OVGN/OpenIRV/README.md

# OpenIRV
Open-source thermal camera project
