OVGN/OpenIRV/SW/FPGA/README.md

# OIRV0901
OIRV0901 is a complete OpenIRV project, based on ISC0901 sensor.

# vivado-git-master
This is a great tool for easy Vivado version control, original repo: https://github.com/barbedo/vivado-git

Preparing Vivado project for use:
1. Download sources.
2. Lauch Vivado, open TCL console: Window -> TCL Console.
3. Run a TCL command: `source your_path_to_project_folder/OIRV0901.tcl`, Vivado will automatically restore project structure.
