OVGN/OpenIRV/docs/BOM/BOM_v1.1.0/OpenIRV_B-board_BOM_v1.1.0.xlsx

Comment | Quantity | Footprint | Designator | Description
B3SE-1002P | 4 | B3SE-1002P | SW0, SW1, SW2, SW3 | Tactile Switch
BM05B-SRSS-TB | 1 | BM05B-SRSS-TB | X1 | Connector
