OVGN/OpenIRV/docs/BOM/BOM_v1.1.0/OpenIRV_D-board_BOM_v1.1.0.xlsx

Comment | Value | Voltage | Dielectric | Tolerance | Quantity | Footprint | Designator | Description | ManufacturerPartNumber
1uF | 1uF | 25v | X7R | 10% | 4 | C0603[1608] | C1, C2, C3, C16 | Capacitor
10uF | 10uF | 50V | X7R | 10% | 4 | C1206[3216] | C4, C5, C6, C13 | Capacitor
0.1uF | 0.1uF | 50V | X7R | 10% | 3 | C0402[1005] | C7, C14, C15 | Capacitor
22uF | 22uF | 10V | X7R | 10% | 4 | C1206[3216] | C9, C10, C11, C12 | Capacitor
BZX384-C15.115 |  |  |  |  | 1 | BZX384 | D1 | Zener diode | BZX384-C15.115
MBRS260T3G |  |  |  |  | 1 | MBRS260T3G | D2 | Diode | MBRS260T3G
MBR0520LT1 |  |  |  |  | 1 | MBR0520LT1 | D3 | Diode | MBR0520LT1
CDRH6D28NP-100NC | 10uH |  |  |  | 1 | CDRH6D28NP-100NC | L1 | Inductor | CDRH6D28NP-100NC
ETQP3M2R2KVP | 2.2uH |  |  |  | 1 | ETQP3MXXXKVP | L2 | Inductor | ETQP3M2R2KVP
SQ2361ES-T1_GE3 |  |  |  |  | 1 | SQ2361ES-T1_GE3 | Q1 | MOSFET P-channel
10K | 10K |  |  | 5% | 2 | R0402[1005] | R1, R9 | Resistor
1K | 1K |  |  | 5% | 1 | R0402[1005] | R2 | Resistor
20R | 20R |  |  | 5% | 5 | R0402[1005] | R3, R4, R5, R6, R8 | Resistor
100R | 100R |  |  | 5% | 1 | R1206[3216] | R7 | Resistor
1M | 1M |  |  | 5% | 1 | R0402[1005] | R10 | Resistor
4.3K | 4.3K |  |  | 1% | 1 | R0603[1608] | R11 | Resistor
100K | 100K |  |  | 5% | 1 | R0402[1005] | R12 | Resistor
100K | 100K |  |  | 1% | 1 | R0603[1608] | R13 | Resistor
28K | 28K |  |  | 1% | 1 | R0603[1608] | R14 | Resistor
CAT4004AHU2-GT3 |  |  |  |  | 1 | CAT4004AHU2-GT3 | U1 | CAT4004AHU2-GT3
LMR33620CDDA |  |  |  |  | 1 | LMR33620CDDA | U2 | DC-DC Synchronous Step-Down converter 2A
XF2M-5015-1A |  |  |  |  | 1 | XF2M-5015-1A | X1 | ER-TFT023-1 TFT LCD Display 2.3" connector
BM14B-SRSS-TB |  |  |  |  | 1 | BM14B-SRSS-TB | X2 | Connector
