OVGN/OpenIRV/docs/BOM/BOM_v1.1.0/OpenIRV_F-board_BOM_v1.1.0.xlsx

Comment | Value | Tolerance | Power | Quantity | Designator | Footprint | Description
300R | 300R | 5% | 0.1W | 1 | R1 | R0603[1608] | Resistor
EE-SX1103 |  |  |  | 1 | U1 | EE-SX1103 | Photomicrosensor
SM03B-SRSS-TB |  |  |  | 1 | X1 | SM03B-SRSS-TB | Connector
SM02B-SRSS-TB |  |  |  | 4 | X2, X3, X4, X5 | SM02B-SRSS-TB | Connector
