OVGN/OpenIRV/docs/BOM/BOM_v1.1.0/OpenIRV_M-board_BOM_v1.1.0.xlsx

Comment | Description | Designator | Footprint | Quantity | Tolerance | Power | Value | Current | Dielectric | ManufacturerPartNumber | Voltage
4.7uF | Capacitor | C1, C2, C3, C9, C10, C15, C16, C21, C22, C26, C27, C33, C34, C38, C39, C93, C94, C100, C101 | C0402[1005] | 19 | 10% |  | 4.7uF |  | X5R |  | 6.3V
0.47uF | Capacitor | C4, C5, C6, C7, C8, C11, C12, C13, C14, C17, C18, C19, C23, C24, C25, C28, C29, C30, C31, C32, C35, C36, C37, C40, C41, C42, C64 | C0402[1005] | 27 | 10% |  | 0.47uF |  | X5R |  | 6.3V
0.1uF | Capacitor | C20, C54, C92, C95, C96, C97, C102, C103, C104, C107, C108, C109, C110 | C0402[1005] | 13 | 10% |  | 0.1uF |  | X7R |  | 50V
10uF | Capacitor | C43, C57, C58, C59, C61, C67, C68, C73, C74, C75, C76, C82, C83, C90, C91 | C0805[2012] | 15 | 10% |  | 10uF |  | X7R |  | 10V
10uF | Capacitor | C45, C46, C49, C50, C52, C53 | C1206[3216] | 6 | 10% |  | 10uF |  | X7R |  | 16V
1uF | Feed Through Capacitor | C47, C48 | NFM21PC | 2 | 20% |  | 1uF | 4A |  | NFM21PC105B1C3D | 16V
0.01uF | Capacitor | C51, C60, C98, C99, C105, C106 | C0402[1005] | 6 | 10% |  | 0.01uF |  | X7R |  | 50V
1uF | Feed Through Capacitor | C55, C56, C80, C81 | NFM18PS | 4 | 20% |  | 1uF | 2A |  | NFM18PS105R0J3D | 6.3V
22uF | Capacitor | C62, C63, C65, C66, C70, C71, C72, C78, C79, C84, C85, C87, C88, C89 | C1206[3216] | 14 | 10% |  | 22uF |  | X7R |  | 10V
120pF | Capacitor | C69 | C0402[1005] | 1 | 10% |  | 120pF |  | X7R |  | 50v
33pF | Capacitor | C77 | C0402[1005] | 1 | 5% |  | 33pF |  | NP0 |  | 50V
SP1001-04JTG | ESD protection diode | D1, D2, D3 | SP1001-04JTG | 3
MBR0520LT1 | Diode | D4 | MBR0520LT1 | 1 |  |  |  |  |  | MBR0520LT1
BLM18KG471SN1D | Ferrite bead | FB1, FB3 | L0603[1608] | 2 |  |  |  | 1.5A |  | BLM18KG471SN1D
BLM15AX102SN1D | Ferrite bead | FB2 | L0402[1005] | 1 |  |  |  | 0.35A |  | BLM15AX102SN1D
BLM15AX601SN1D | Ferrite bead | FB4 | L0402[1005] | 1 |  |  |  | 0.5A |  | BLM15AX601SN1D
BLM15PD121SN1D | Ferrite bead | FB5 | L0402[1005] | 1 |  |  |  | 1.3A |  | BLM15PD121SN1D
SG-8018CG XX.XXXXM-TJHSA3 | Oscillator | G1 | SG-8018CG XX.XXXXM-TJHSA3 | 1 |  |  |  |  |  | SG-8018CG XX.XXXXM-TJHSA3
LQM21PN4R7MGRD | Inductor | L1 | L0805[2012] | 1 |  |  | 4.7uH |  |  | LQM21PN4R7MGRD
LQM2HPN2R2MG0L | Inductor | L2, L4 | LQM2HPNXXXXG0X | 2 |  |  | 2.2uH |  |  | LQM2HPN2R2MG0L
DFE252012P-R47M=P2 | Inductor | L3 | DFE252012P-XXXM=P2 | 1 |  |  | 0.47uH |  |  | DFE252012P-R47M=P2
LQM2HPN1R5MG0L | Inductor | L5 | LQM2HPNXXXXG0X | 1 |  |  | 1.5uH |  |  | LQM2HPN1R5MG0L
FDV303N | MOSFET N-channel | Q1, Q2 | FDV303N | 2
FDN306P | MOSFET P-channel | Q3 | FDN306P | 1
22R | Resistor array | R1, R2, R3, R4, R5, R7, R8 | R0804 | 7 | 5% | 0.06W | 22R
10K | Resistor | R6, R10, R11, R12, R13, R14, R20, R24, R28, R32, R36, R40, R45, R49, R55, R58, R65, R66, R67, R68, R69 | R0402[1005] | 21 | 5% | 0.06W | 10K
4.7K | Resistor | R9, R22, R23, R25, R26 | R0402[1005] | 5 | 5% | 0.06W | 4.7K
20R | Resistor | R15, R16, R17, R18, R19, R21 | R0402[1005] | 6 | 5% | 0.06W | 20R
100K | Resistor | R27, R47, R51 | R0603[1608] | 3 | 1% | 0.1W | 100K
15.4K | Resistor | R29 | R0603[1608] | 1 | 1% | 0.1W | 15.4K
60.4K | Resistor | R30 | R0603[1608] | 1 | 1% | 0.1W | 60.4K
47R | Resistor | R31, R39, R56 | R0402[1005] | 3 | 5% | 0.06W | 47R
1R | Resistor | R33, R41 | R0603[1608] | 2 | 1% | 0.1W | 1R
10R | Resistor | R34 | R0603[1608] | 1 | 1% | 0.1W | 10R
17.8K | Resistor | R35 | R0603[1608] | 1 | 1% | 0.1W | 17.8K
2.7K | Resistor | R37 | R0603[1608] | 1 | 1% | 0.1W | 2.7K
10.5K | Resistor | R38 | R0603[1608] | 1 | 1% | 0.1W | 10.5K
0R1 | Resistor | R42, R57 | R0603[1608] | 2 | 1% | 0.1W | 0R1
12K | Resistor | R43 | R0603[1608] | 1 | 1% | 0.1W | 12K
3.83K | Resistor | R46 | R0603[1608] | 1 | 1% | 0.1W | 3.83K
49.9K | Resistor | R48 | R0603[1608] | 1 | 1% | 0.1W | 49.9K
68K | Resistor | R50, R59 | R0603[1608] | 2 | 1% | 0.1W | 68K
56K | Resistor | R52 | R0603[1608] | 1 | 1% | 0.1W | 56K
130K | Resistor | R53 | R0603[1608] | 1 | 1% | 0.1W | 130K
12.4K | Resistor | R54 | R0603[1608] | 1 | 1% | 0.1W | 12.4K
11.3K | Resistor | R60 | R0603[1608] | 1 | 1% | 0.1W | 11.3K
1K | Resistor | R61, R62 | R0402[1005] | 2 | 5% | 0.06W | 1K
100K | Resistor | R63, R64 | R0402[1005] | 2 | 5% | 0.06W | 100K
XC7S50-1CSGA324C | Spartan-7 FPGA, pin compatible with 7S25 | U1 | XC7S50-1CSGA324C | 1
MX25L12835F | Quad SPI NOR Flash 128Mbit | U2 | MX25L12835F | 1
TPS61041DBVR | DC-DC boost converter | U3 | TPS61041DBVR | 1
TPS7A4901DGNR | Ultralow-Noise Positive LDO 150ma | U4 | TPS7A4901DGNR | 1
TPS7A9001DSKR | LDO Low-Noise 500ma | U5 | TPS7A9001DSKR | 1
TPS62400DRCT | Dual Step-Down DC-DC | U6 | TPS62400DRCT | 1
TPS62821DLCR | DC-DC Step-Down Converter | U7 | TPS62821DLCR | 1
TPS63030DSKR | DC-DC 1A Buck-Boost Converter | U8 | TPS63030DSKR | 1
LP5912-3.3DRVR | LDO 500ma, Fixed 3.3 V | U9 | LP5912-3.3DRVR | 1
W956D8MBYA5I | HyperBus PSRAM 64Mbit | U10, U11 | W956D8MBYA5I | 2
NC7WZ07P6X | Dual open-drain buffer | U12 | NC7WZ07P6X | 1
SN74LVC1T45DBVR | Single-Bit Dual-Supply Bus Transceiver | U13, U14, U15 | SN74LVC1T45DBVR | 3
DF17-80 | Connector | X1 | DF17(2.0)-80DP-0.5V(57) | 1
52991-0408 (ISC0901B0 pinout) | Molex 40 pin receptacle | X2 | 52991-0408 | 1
SM10B-SRSS-TB | Connector | X3 | SM10B-SRSS-TB | 1
84953-6 | Connector | X4 | 84953-6 | 1
