OVGN/OpenIRV/docs/BOM/BOM_v1.1.0/OpenIRV_P-board_BOM_v1.1.0.xlsx

Comment | Description | Designator | Footprint | Quantity | ManufacturerPartNumber | Power | Tolerance | Value | Current | Dielectric | Voltage
1095 | Battery holder 18350 | BT1 | 1095 | 1
12pF | Capacitor | C1, C2 | C0402[1005] | 2 |  |  | 5% | 12pF |  | NP0 | 50V
0.1uF | Capacitor | C3, C4, C7, C8, C9, C10, C11, C13, C15, C19, C20, C21, C22, C23, C24, C34, C35, C36, C37, C47 | C0402[1005] | 20 |  |  | 10% | 0.1uF |  | X7R | 50V
1uF | Capacitor | C5, C17, C18, C45, C48 | C0603[1608] | 5 |  |  | 10% | 1uF |  | X7R | 25V
10uF | Capacitor | C6, C12, C14, C39, C40, C43, C44 | C0805[2012] | 7 |  |  | 10% | 10uF |  | X7R | 10V
22uF | Capacitor | C16, C38 | C1206[3216] | 2 |  |  | 10% | 22uF |  | X7R | 10V
2.2nF | Capacitor | C25 | C0603[1608] | 1 |  |  | 10% | 2.2nF |  | X7R | 50V
1uF | Feed Through Capacitor | C26, C31 | NFM18PS | 2 | NFM18PS105R0J3D |  | 20% | 1uF | 2A |  | 6.3V
12nF | Capacitor | C27 | C0603[1608] | 1 |  |  | 10% | 12nF |  | X7R | 50V
4.7uF | Capacitor | C28, C29, C32, C33 | C0402[1005] | 4 |  |  | 10% | 4.7uF |  | X5R | 6.3V
150nF | Capacitor | C30 | C0603[1608] | 1 |  |  | 10% | 150nF |  | X7R | 50V
0.22uF | Capacitor | C41, C46 | C0603[1608] | 2 |  |  | 10% | 0.22uF |  | X7R | 25V
0.01uF | Capacitor | C42 | C0402[1005] | 1 |  |  | 10% | 0.01uF |  | X7R | 50V
USBLC6-2P6 | ESD protection diode | D1 | USBLC6-2P6 | 1
BAS70JFILM | Diode | D2, D4, D12 | BAS70JFILM | 3 | BAS70JFILM
SP3012-04UTG | ESD protection diode | D3, D6 | SP3012-04UTG | 2
SP1001-04JTG | ESD protection diode | D5, D11 | SP1001-04JTG | 2
SP1001-02JTG | ESD protection diode | D7 | SP1001-02JTG | 1
WP117EYWT | LED | D8 | LED_AXIAL[7x5x2] | 1 | WP117EYWT
BZX384-C15.115 | Zener diode | D9 | BZX384 | 1 | BZX384-C15.115
SMBJ33A/CA | TVS diode | D10 | SMBJ33A/CA | 1 | SMBJ33A/CA
BAR43CFILM | Diode | D13, D14 | BAR43CFILM | 2
L-117EGWT | LED | D15 | LED_AXIAL[7x5x2] | 1 | L-117EGWT
BLM15AX102SN1D | Ferrite Bead | FB1, FB2, FB3 | L0402[1005] | 3 | BLM15AX102SN1D |  |  |  | 0.35A
LQM21PN4R7MGRD | Inductor | L1, L2, L3, L4, L5 | L0805[2012] | 5 | LQM21PN4R7MGRD |  |  | 4.7uH
97730506332R | Spacer M1.6 | MH1, MH2 | 97730506332R | 2
NTJD4401NT1G | Dual N-channel mosfet | Q1, Q2, Q4, Q5 | NTJD4401NT1G | 4
SQ2361ES-T1_GE3 | MOSFET P-channel | Q3 | SQ2361ES-T1_GE3 | 1
SI2333DDS-T1-GE3 | MOSFET P-channel | Q6, Q7 | SI2333DDS-T1-GE3 | 2
2.4K | Resistor | R1, R2, R16, R17 | R0402[1005] | 4 |  | 0.06W | 5% | 2.4K
10K | Resistor | R3, R4, R5, R6, R7, R8, R9, R10, R19, R22, R23, R24, R25, R26, R27, R28, R31, R33, R34, R37, R38, R39, R40, R47, R48, R52, R53, R58, R59, R61, R62, R63, R66, R67, R70, R71, R72, R79 | R0402[1005] | 38 |  | 0.06W | 5% | 10K
49R9 | Resistor | R11, R12, R13, R14 | R0404 | 4 |  | 0.06W | 1% | 49R9
27K | Resistor | R15, R21 | R0603[1608] | 2 |  | 0.1W | 1% | 27K
0R | Resistor | R18, R36, R41 | R0402[1005] | 3 |  | 0.06W | 5% | 0R
1K | Resistor | R20, R32, R42, R43, R44, R45, R46, R57, R69, R74, R75, R76 | R0402[1005] | 12 |  | 0.06W | 5% | 1K
62R | Resistor | R29, R35 | R0603[1608] | 2 |  | 0.1W | 5% | 62R
0466002.NR | Fuze | R30 | R1206[3216] | 1 | 0466002.NR |  |  |  | 2A
300R | Resistor | R49 | R0603[1608] | 1 |  | 0.1W | 1% | 300R
169R | Resistor | R50 | R0603[1608] | 1 |  | 0.1W | 1% | 169R
4.12K | Resistor | R51 | R0603[1608] | 1 |  | 0.1W | 1% | 4.12K
75R | Resistor | R54 | R0603[1608] | 1 |  | 0.1W | 1% | 75R
240R | Resistor | R55 | R0603[1608] | 1 |  | 0.1W | 5% | 240R
200R | Resistor | R56 | R0603[1608] | 1 |  | 0.1W | 5% | 200R
0ZCM0010FF2G | Fuze | R60 | R0603[1608] | 1 | 0ZCM0010FF2G |  |  |  | 0.1A
1.07K | Resistor | R64 | R0603[1608] | 1 |  | 0.1W | 1% | 1.07K
33.2K | Resistor | R65 | R0603[1608] | 1 |  | 0.1W | 1% | 33.2K
60.4K | Resistor | R68 | R0603[1608] | 1 |  | 0.1W | 1% | 60.4K
680R | Resistor | R73 | R0603[1608] | 1 |  | 0.1W | 1% | 680R
0.05R | Resistor | R77, R78 | R1206[3216] | 2 |  | 0.25W | 1% | 0.05R
EVQP7L01P | Tactile Switch | SW1 | EVQP7L01P | 1 | EVQP7L01P
CY7C68013A-56PVXI | EZ-USB(R) FX2LP(TM) USB Microcontroller High-Speed USB Peripheral Controller, 16 KB, 24 I/Os, 3 to 3.6 V, -40 to 85 degC, 56-Pin SSOP (PVX56), Tube | U1 | CY7C68013A-56PVXI | 1
NCV361SNT1G | USB Positive Overvoltage/Overcurrent Protection | U2 | NCV361SNT1G | 1
NL17SZ125DFT2G | Non-Inverting 3-State Buffer | U3 | NL17SZ125DFT2G | 1
M41T62LC6F | Real Time Clock | U4 | M41T62LC6F | 1
DRV8835DSSR | Dual Low Voltage H-Bridge IC | U5 | DRV8835DSSR | 1
PCA9539PW | PCA9539PW | U6 | PCA9539PW | 1
ADV7391BCPZ | 10-bit SD/HD Video Encoder | U7 | ADV7391BCPZ | 1
ADA4432-1BRJZ-R2 | Analog Video output buffer | U8 | ADA4432-1BRJZ-R2 | 1
BQ24032ARHLR | Dual Input Li-Ion Charger with Dynamic Power Path, Output regulated to 4.4 V, Vbat 4.2 V, 4.3 V, -40 to 85 degC, 20-pin QFN (RHL), Green (RoHS & no Sb/Br) | U9 | BQ24032ARHLR | 1
TPS61222DCKR | DC-DC Boost converter | U10 | TPS61222DCKR | 1
STC3115AIQT | Gas gauge IC with alarm output for handheld applications | U11 | STC3115AIQT | 1
LC05111C02MTTTG | 1-Cell Lithium-Ion Battery Protection IC with Integrated Power MOSFET | U12 | LC05111C02MTTTG | 1
61400416121 | USB 2.0 type B | X1 | 61400416121 | 1
DF17-80 | Connector | X2 | DF17(3.0)-80DS-0.5V(57) | 1
DM3AT-SF-PEJM5 | SD card slot | X3 | DM3AT-SF-PEJM5 | 1
HDMI receptacle connector | Connector | X4 | 471510001_EDGE_HOLE | 1
BM14B-SRSS-TB | Connector | X5 | BM14B-SRSS-TB | 1
BM02B-SRSS-TB | Connector | X6 | BM02B-SRSS-TB | 1
SM02B-SRSS-TB | Connector | X7 | SM02B-SRSS-TB | 1
S7B-XH-A | JST connector 2.5mm 7-pin | X8 | S7B-XH-A | 1
BM03B-SRSS-TB | Connector | X9 | BM03B-SRSS-TB | 1
BM05B-SRSS-TB | Connector | X10 | BM05B-SRSS-TB | 1
KX-7T | Crystal | Y1 | Crystal[3225] | 1 | KX-7T
