OVGN/OpenIRV/HW/mechanical/STEP/focus/motor_mount.stp

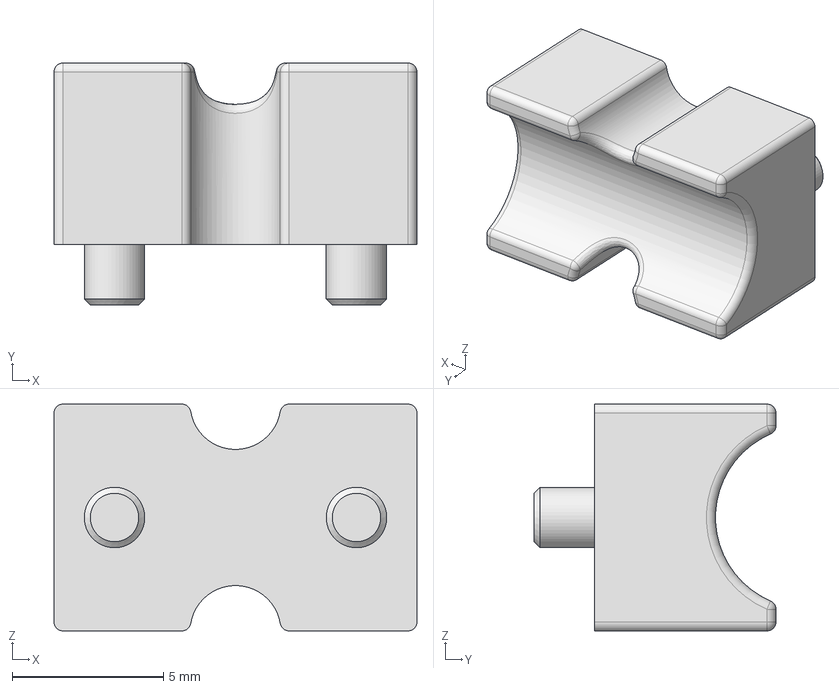
[picture p5: CAD file, 2020-08-25]
HW/mechanical/STEP/focus/motor_mount.stp
12.0 x 8.00 x 7.50 mm
