OVGN/OpenIRV/HW/mechanical/STEP/housing/buttons/buttons_matrix.stp

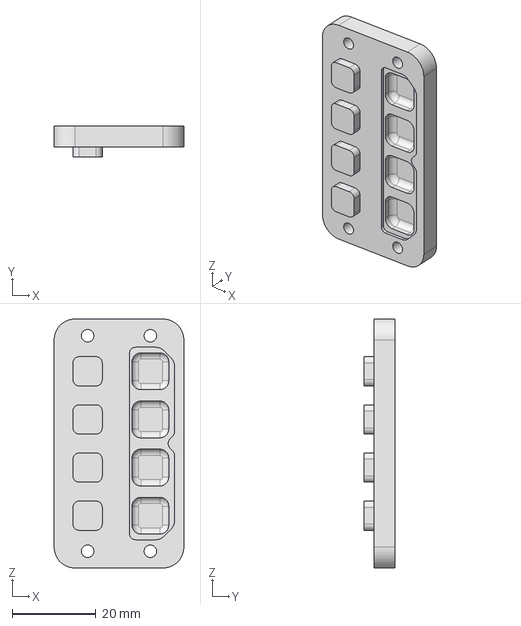
[picture p6: CAD file, 2020-08-25]
HW/mechanical/STEP/housing/buttons/buttons_matrix.stp
31.0 x 7.30 x 59.5 mm
