OVGN/OpenIRV/HW/mechanical/STEP/housing/top.stp

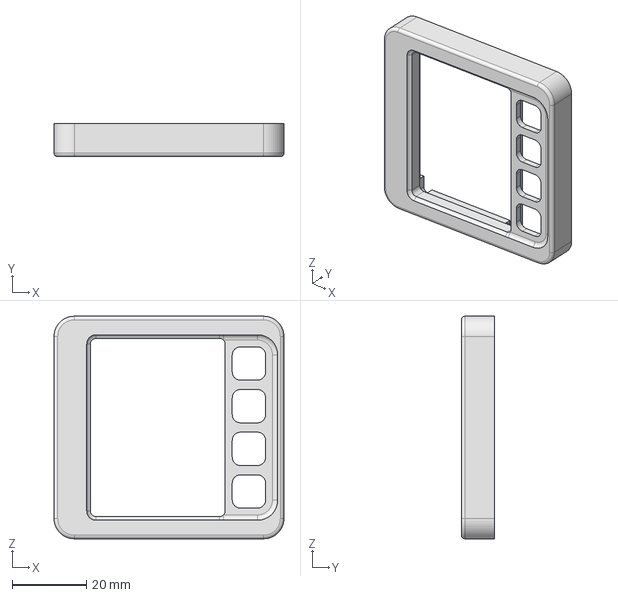
[picture p7: CAD file, 2020-08-25]
HW/mechanical/STEP/housing/top.stp
62.0 x 9.00 x 60.0 mm
