OVGN/OpenIRV/HW/mechanical/STEP/pixelshift/pixelshift_xy_stage.stp

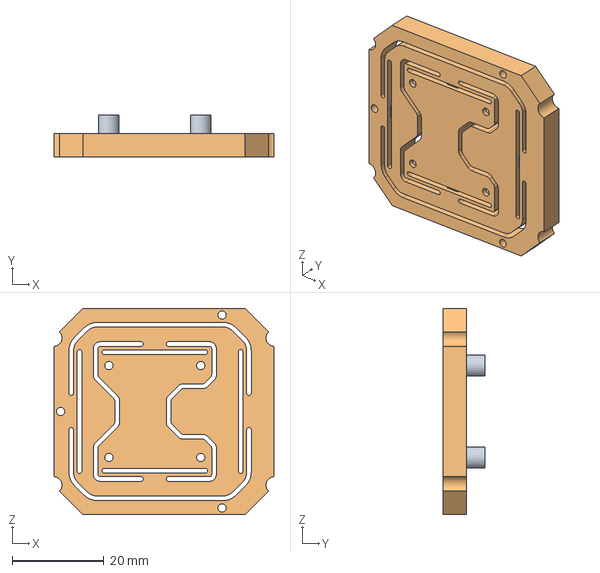
[picture p8: CAD file, 2020-11-22]
HW/mechanical/STEP/pixelshift/pixelshift_xy_stage.stp
47.9 x 9.10 x 44.9 mm
