OVGN/OpenIRV/HW/mechanical/STEP/focus/focus_worm.stp

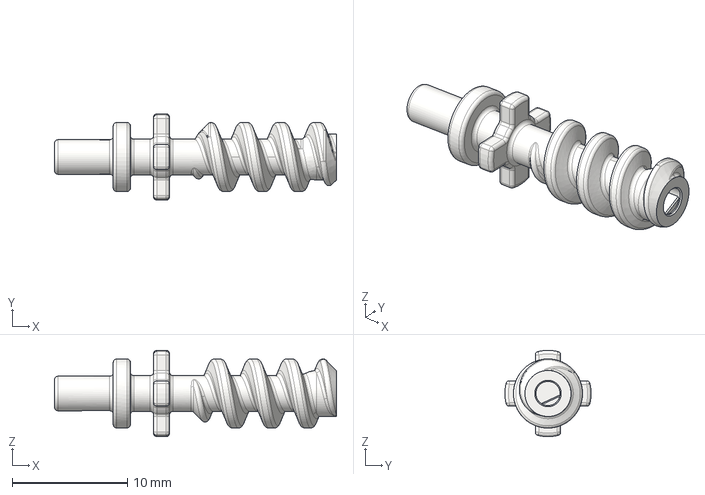
[picture p9: CAD file, 2020-08-25]
HW/mechanical/STEP/focus/focus_worm.stp
24.5 x 7.50 x 7.50 mm
