OVGN/OpenIRV/HW/mechanical/STEP/housing/buttons/buttons.stp

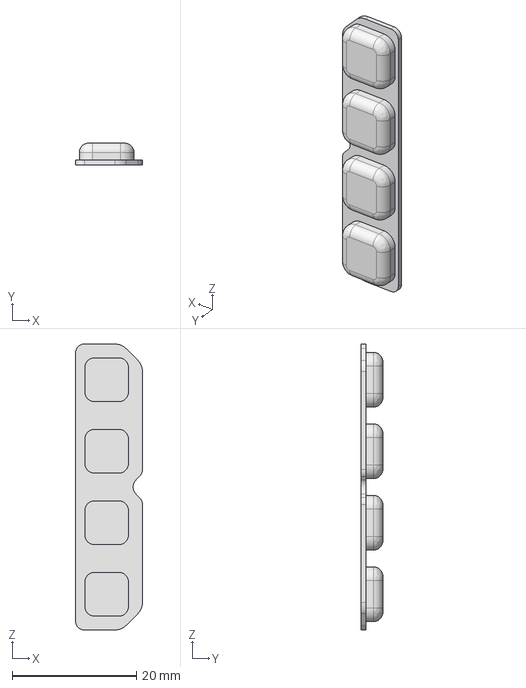
[picture p10: CAD file, 2020-08-25]
HW/mechanical/STEP/housing/buttons/buttons.stp
10.8 x 3.50 x 46.0 mm
