OVGN/OpenIRV/HW/mechanical/STEP/housing/middle.stp

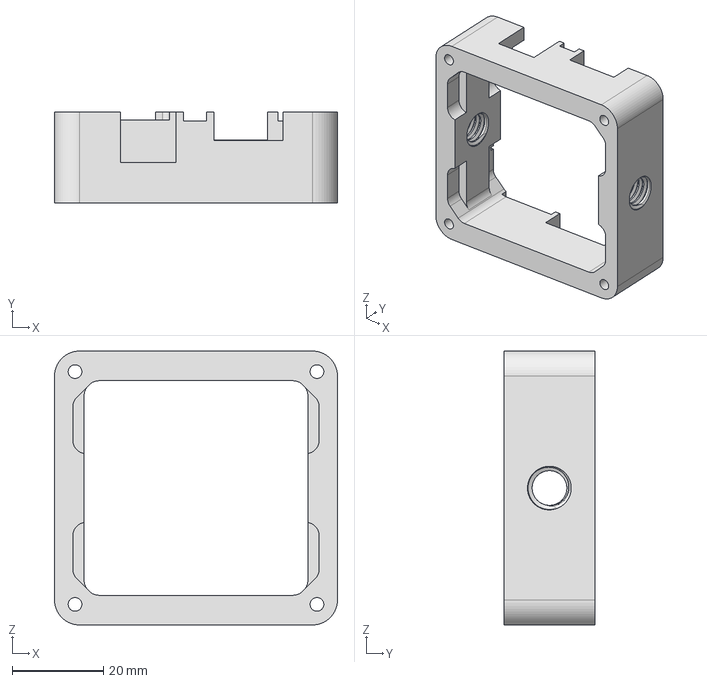
[picture p11: CAD file, 2020-08-25]
HW/mechanical/STEP/housing/middle.stp
62.0 x 20.0 x 60.0 mm
