OVGN/OpenIRV/HW/mechanical/STEP/focus/focus_wheel.stp

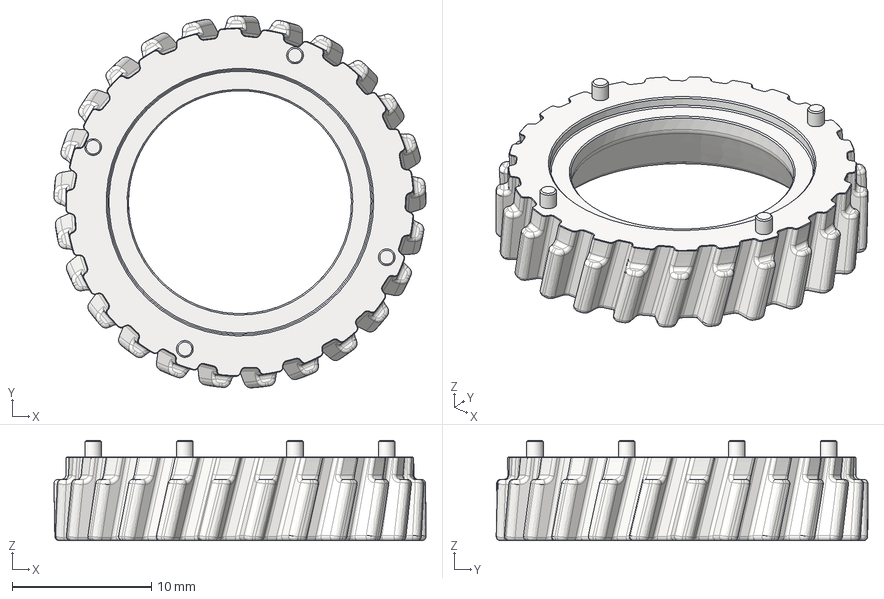
[picture p12: CAD file, 2020-08-25]
HW/mechanical/STEP/focus/focus_wheel.stp
26.7 x 26.7 x 7.20 mm
