OVGN/OpenIRV/HW/mechanical/STEP/housing/bottom_h13.stp

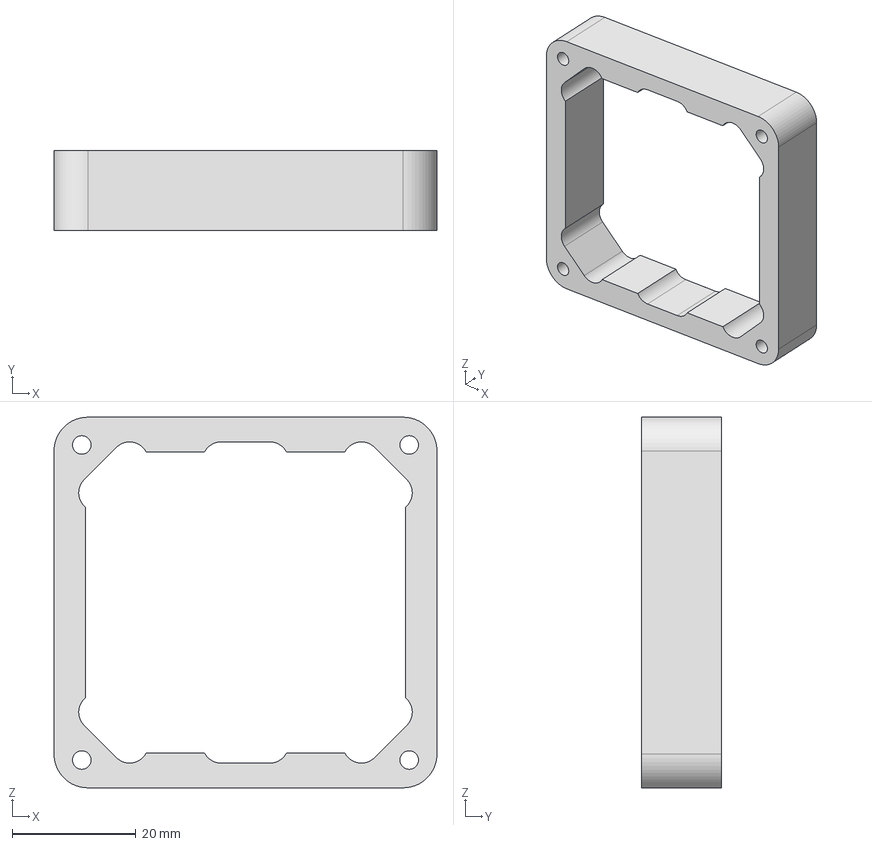
[picture p13: CAD file, 2020-08-25]
HW/mechanical/STEP/housing/bottom_h13.stp
62.0 x 13.0 x 60.0 mm
