OVGN/OpenIRV/HW/mechanical/STEP/focus/worm_mount.stp

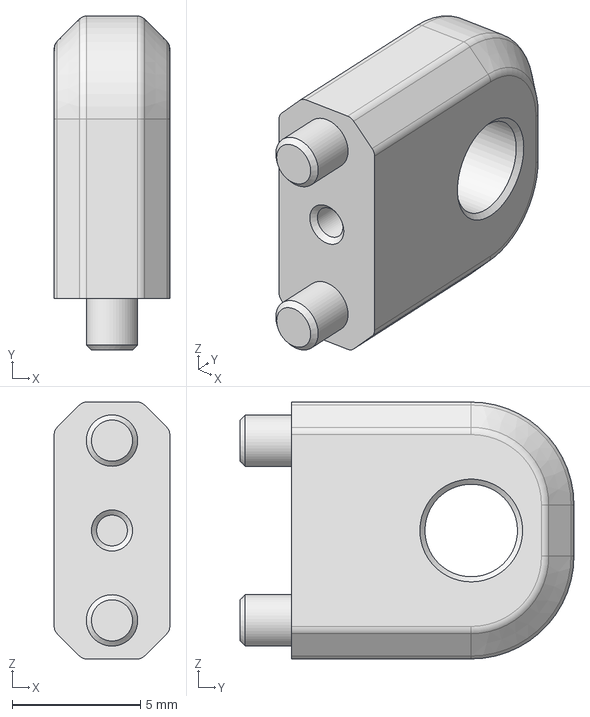
[picture p14: CAD file, 2020-08-25]
HW/mechanical/STEP/focus/worm_mount.stp
4.50 x 13.0 x 10.0 mm
