OVGN/OpenIRV/HW/mechanical/STEP/housing/bottom_h7.stp

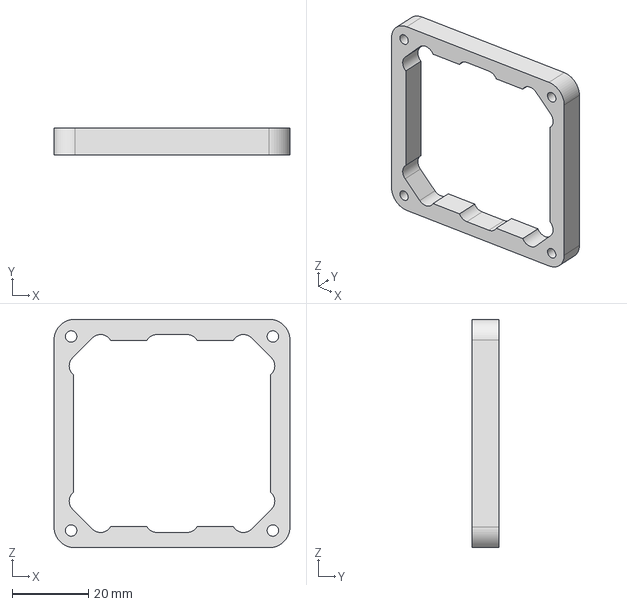
[picture p15: CAD file, 2020-08-25]
HW/mechanical/STEP/housing/bottom_h7.stp
62.0 x 7.00 x 60.0 mm
