OVGN/OpenIRV/docs/schematics/D-board_v1.1.0.PDF

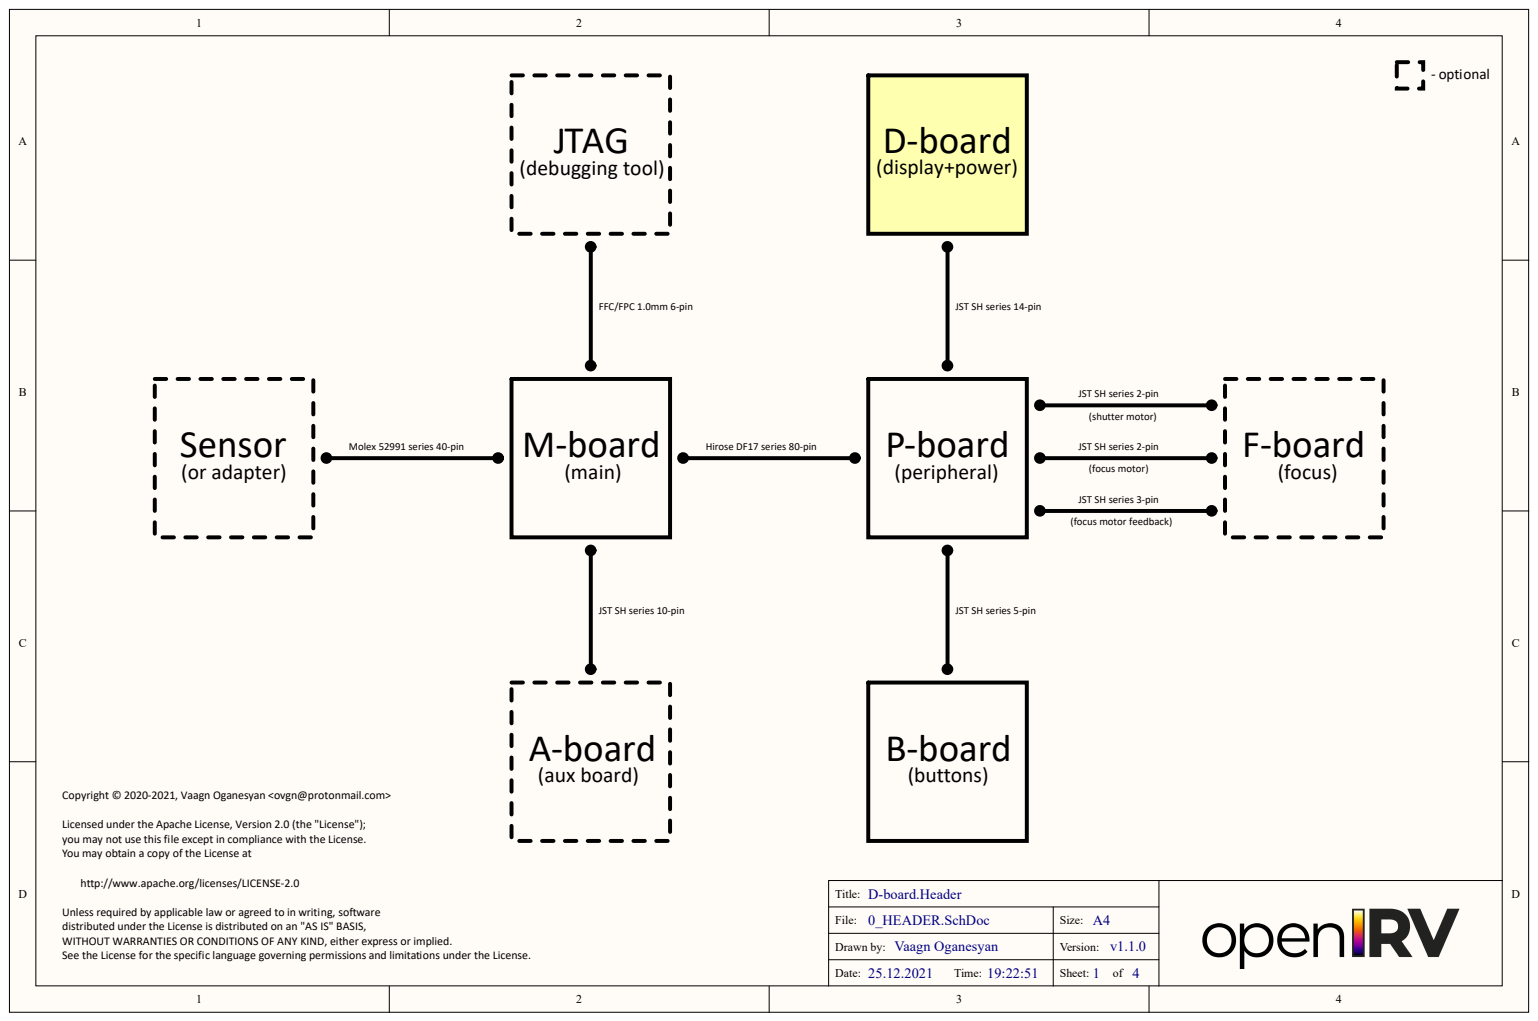
[picture p21: page 1]

JST SH series 14-pin

JST SH series 2-pin

JST SH series 3-pin

JST SH series 10-pin

JST SH series 5-pin

Copyright © 2020-2021, Vaagn Oganesyan <ovgn@protonmail.com>

Licensed under the Apache License, Version 2.0 (the "License");
you may not use this file except in compliance with the License.
You may obtain a copy of the License at

http://www.apache.org/licenses/LICENSE-2.0

Title: D-board.Header

Unless required by applicable law or agreed to in writing, software
distributed under the License is distributed on an "AS IS" BASIS,
WITHOUT WARRANTIES OR CONDITIONS OF ANY KIND, either express or implied.
See the License for the specific language governing permissions and limitations under the License.

File: 0_HEADER.SchDoc | Size: A4

Drawn by: Vaagn Oganesyan | Version: v1.1.0

Date: 25.12.2021 Time: 19:22:51 | Sheet: 1 of 4

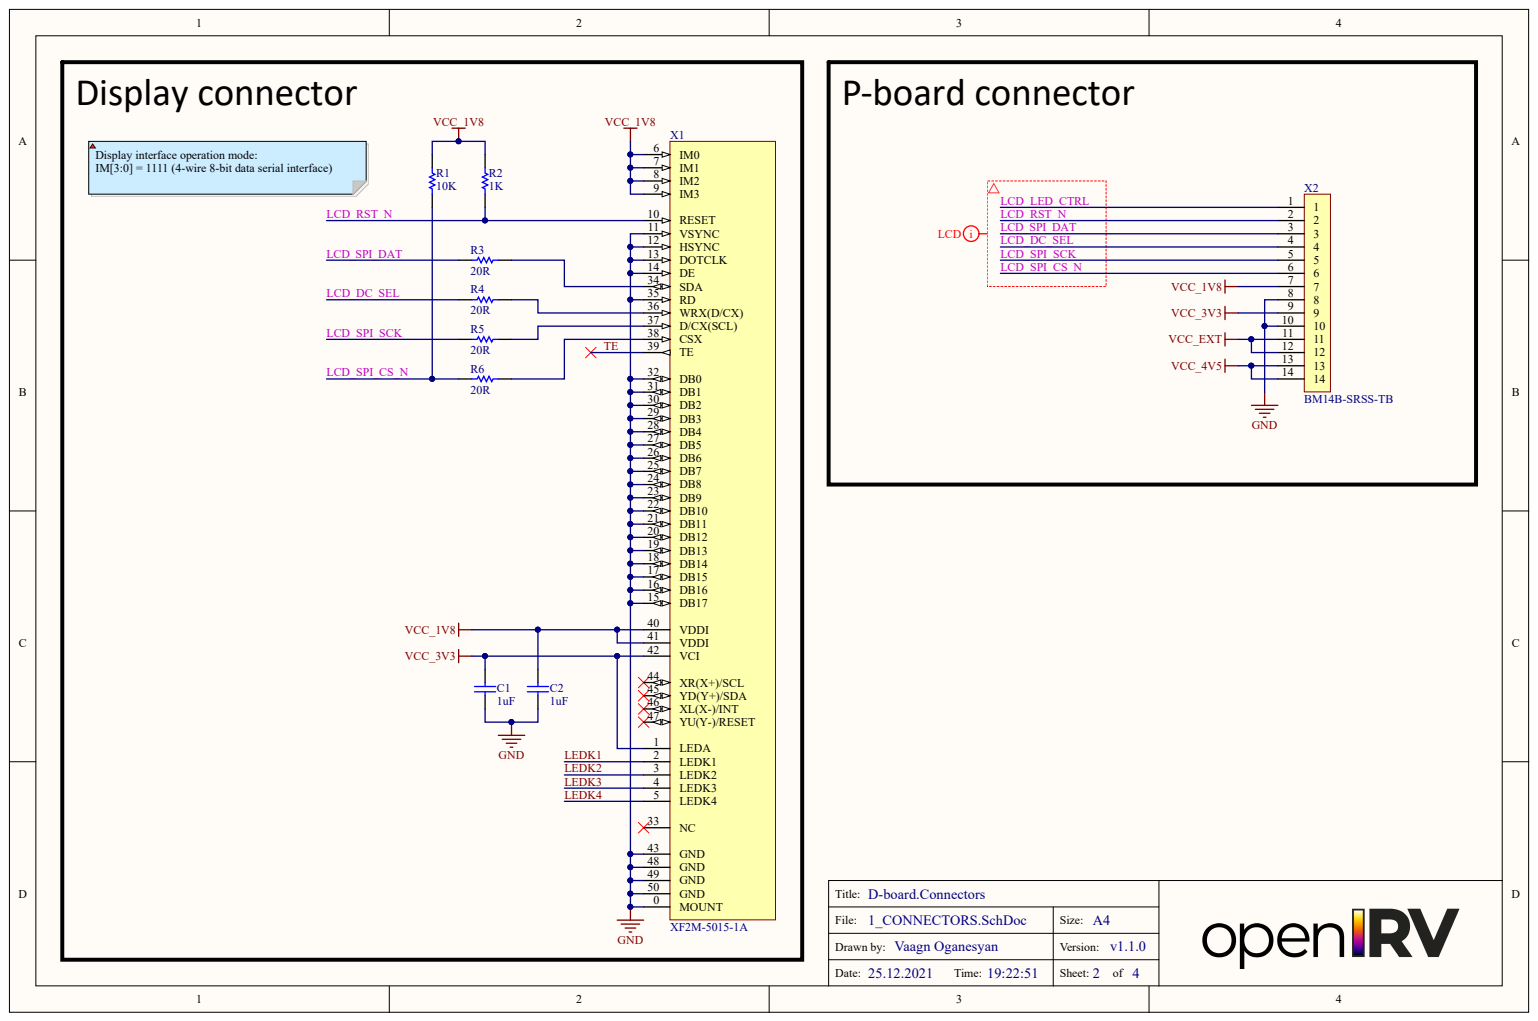
[picture p22: page 2]

Display interface operation mode:

11 (4-wire 8-bit data serial interface)

D/CX(SCL) 37

VDDI 41

C1 | | XR(X+)/SCL 44

File: 1_CONNECTORS.SchDoc | Size: Version: A4

Drawn by: Vaagn Oganesyan | v1.1.0

Date: 25.12.2021 Time: 19:22:51 | Sheet: 2 of

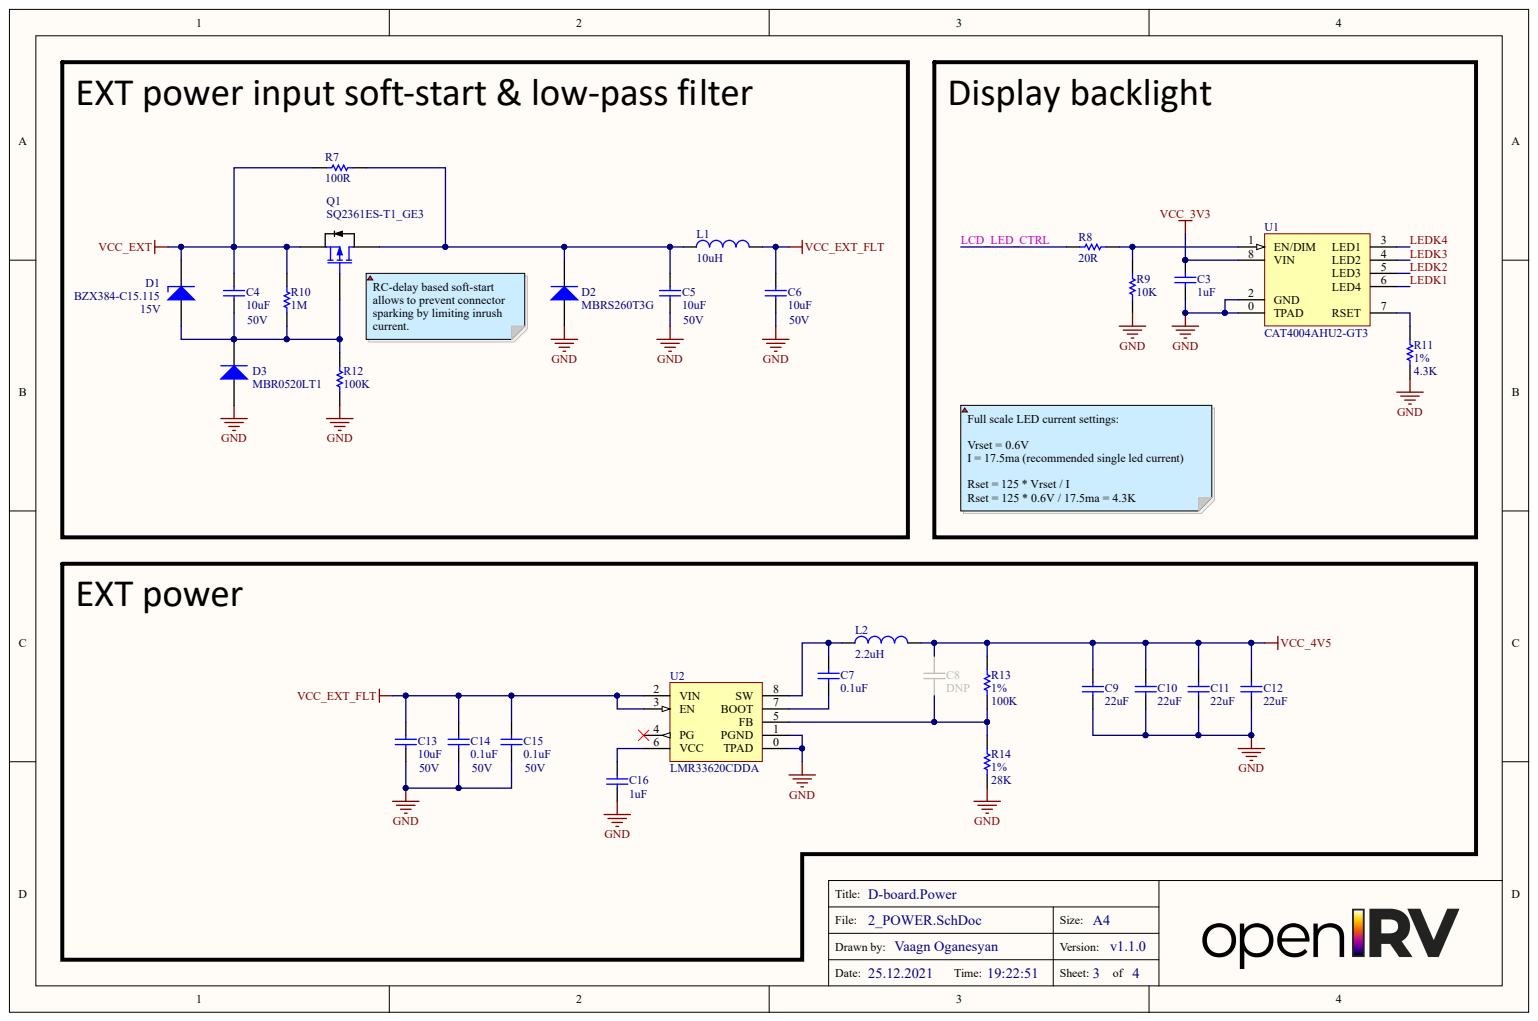
[picture p23: page 3]

EXT power input soft-start & low-pass filter

RC-delay based soft-start
allows to prevent connector
sparking by limiting inrush
current.

Full scale LED current settings:

Vrset = 0.6V
I = 17.5ma (recommended single led current)

Title: D-board.Power

File: 2_POWER.SchDoc | Size: A4

Drawn by: Vaagn Oganesyan | Version: v1.1.0


Title: D-board.ChangeLog

File: 3_CHANGELOG.SchDoc | Size: A4

Drawn by: Vaagn Oganesyan | Version: v1.1.0
