OVGN/OpenIRV/docs/schematics/F-board_v1.1.0.PDF

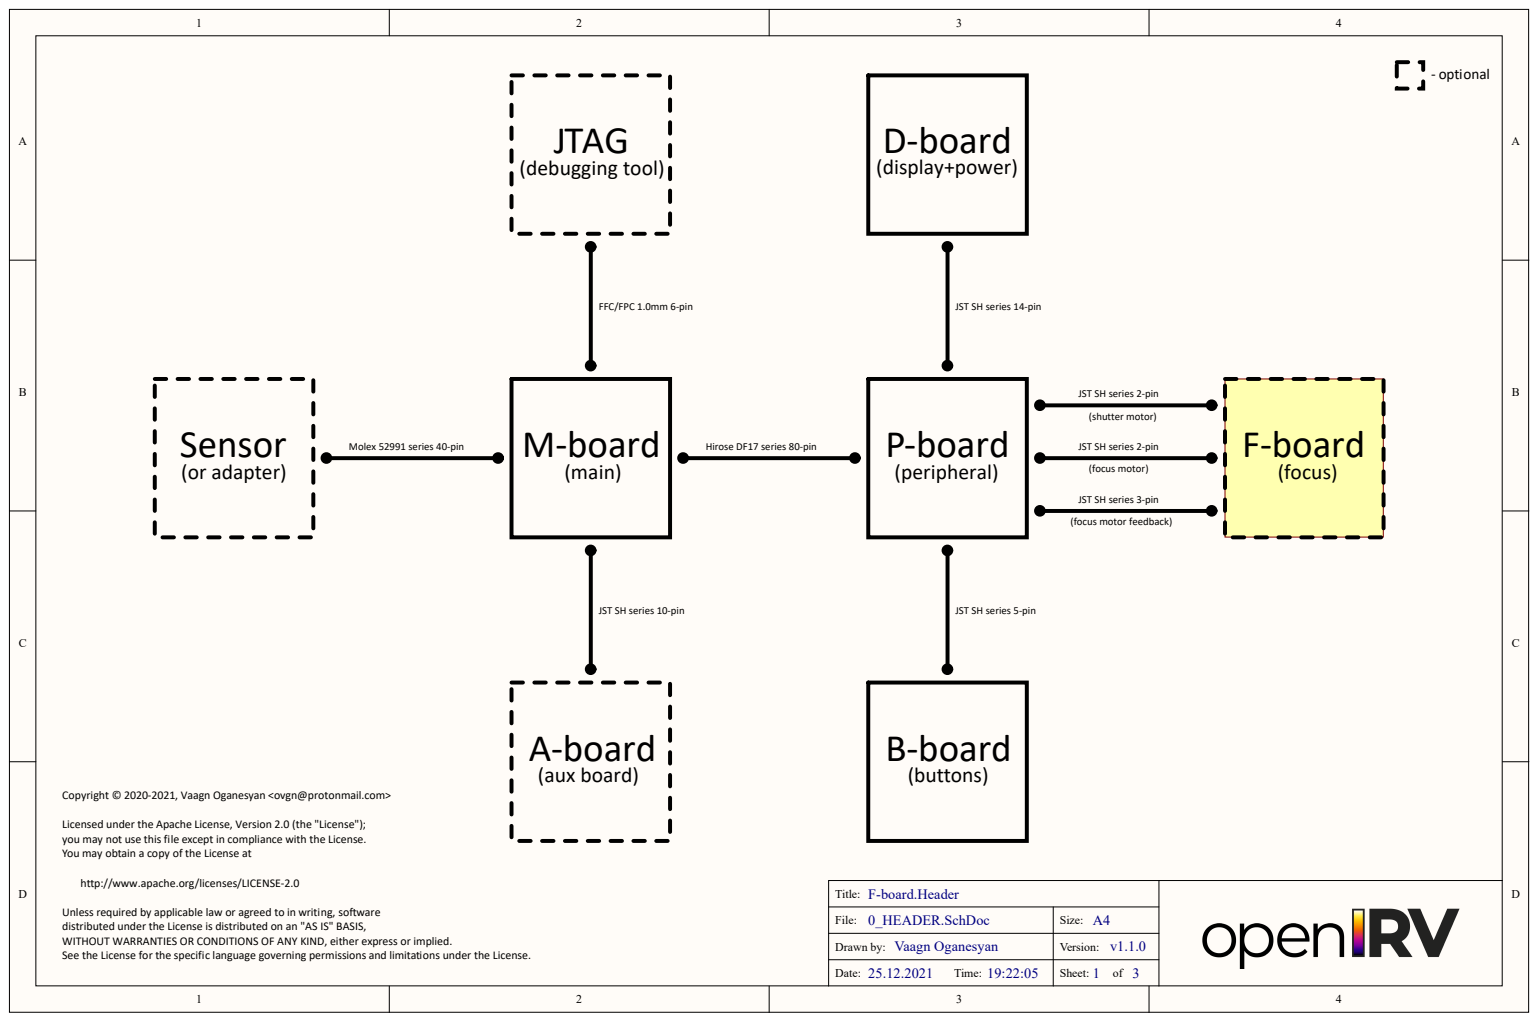
[picture p24: page 1]

JST SH series 14-pin

JST SH series 2-pin

JST SH series 3-pin

JST SH series 10-pin

JST SH series 5-pin

Copyright © 2020-2021, Vaagn Oganesyan <ovgn@protonmail.com>

Licensed under the Apache License, Version 2.0 (the "License");
you may not use this file except in compliance with the License.
You may obtain a copy of the License at

http://www.apache.org/licenses/LICENSE-2.0

Title: F-board.Header

Unless required by applicable law or agreed to in writing, software
distributed under the License is distributed on an "AS IS" BASIS,
WITHOUT WARRANTIES OR CONDITIONS OF ANY KIND, either express or implied.
See the License for the specific language governing permissions and limitations under the License.

File: 0_HEADER.SchDoc | Size: A4

Drawn by: Vaagn Oganesyan | Version: v1.1.0

Date: 25.12.2021 Time: 19:22:05 | Sheet: 1 of 3

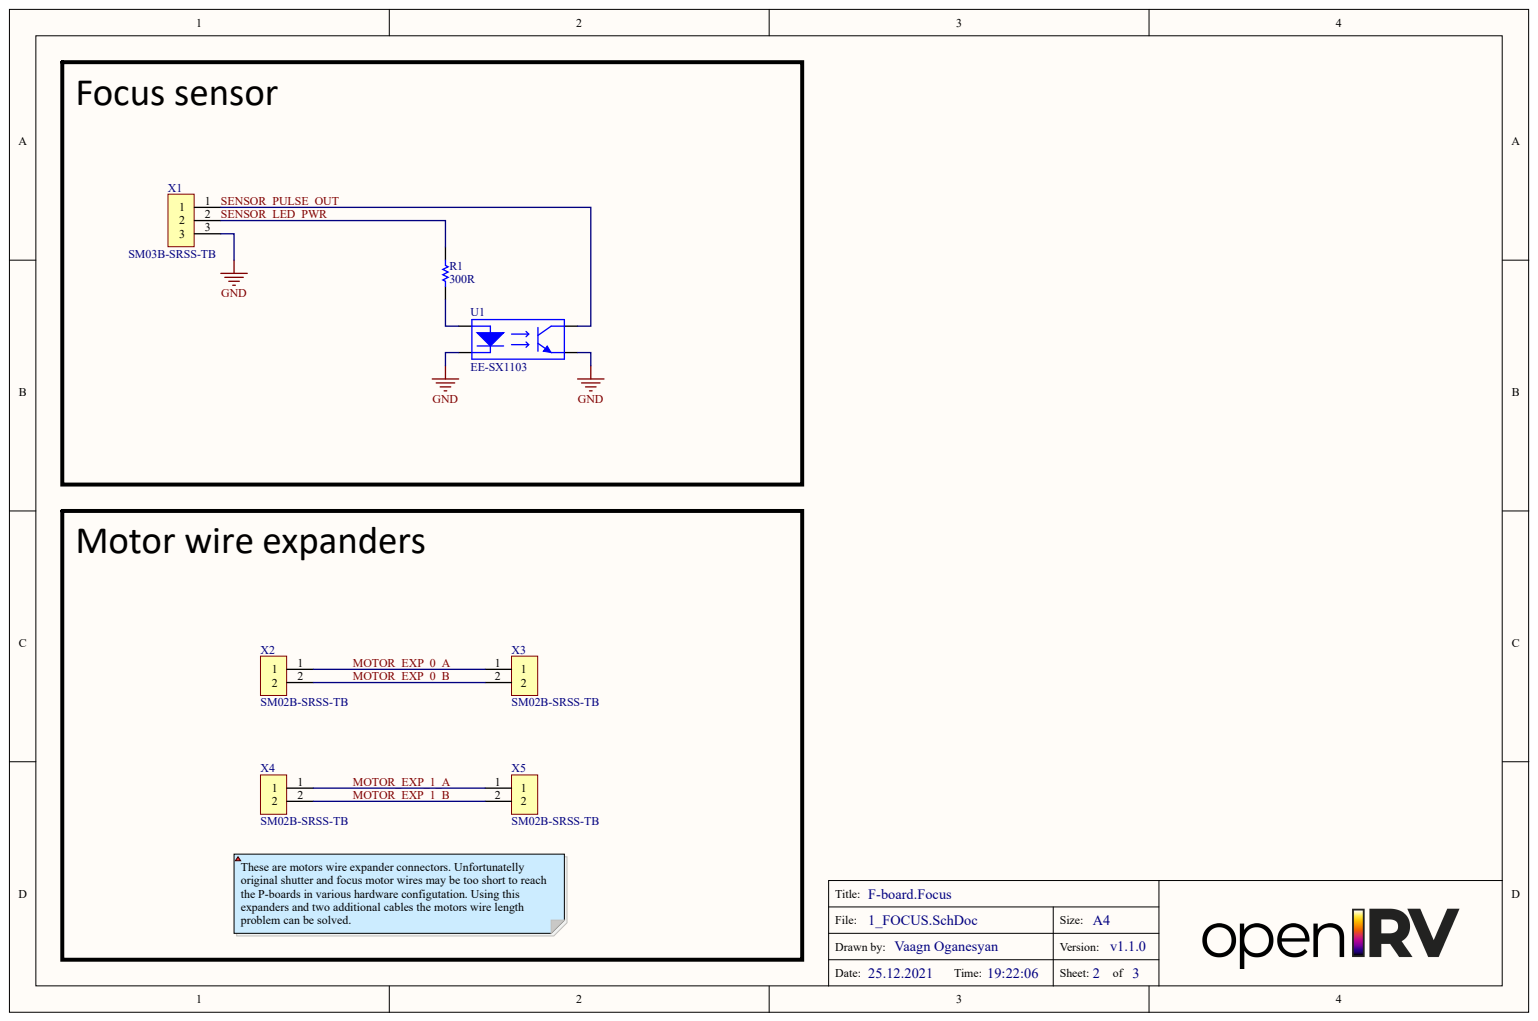
[picture p25: page 2]

These are motors wire expander connectors. Unfortunatelly
original shutter and focus motor wires may be too short to reach
the P-boards in various hardware configutation. Using this
expanders and two additional cables the motors wire length
problem can be solved.

Title: F-board.Focus

File: 1_FOCUS.SchDoc | Size: A4

Drawn by: Vaagn Oganesyan | Version: v1.1.0

Date: 25.12.2021 Time: 19:22:06 | Sheet: 2 of 3


Title: F-board.ChangeLog

File: 2_CHANGELOG.SchDoc | Size: A4

Drawn by: Vaagn Oganesyan | Version: v1.1.0

Date: 25.12.2021 Time: 19:22:06 | Sheet: 3 of 3
