OVGN/OpenIRV/docs/schematics/M-board_v1.1.0.PDF

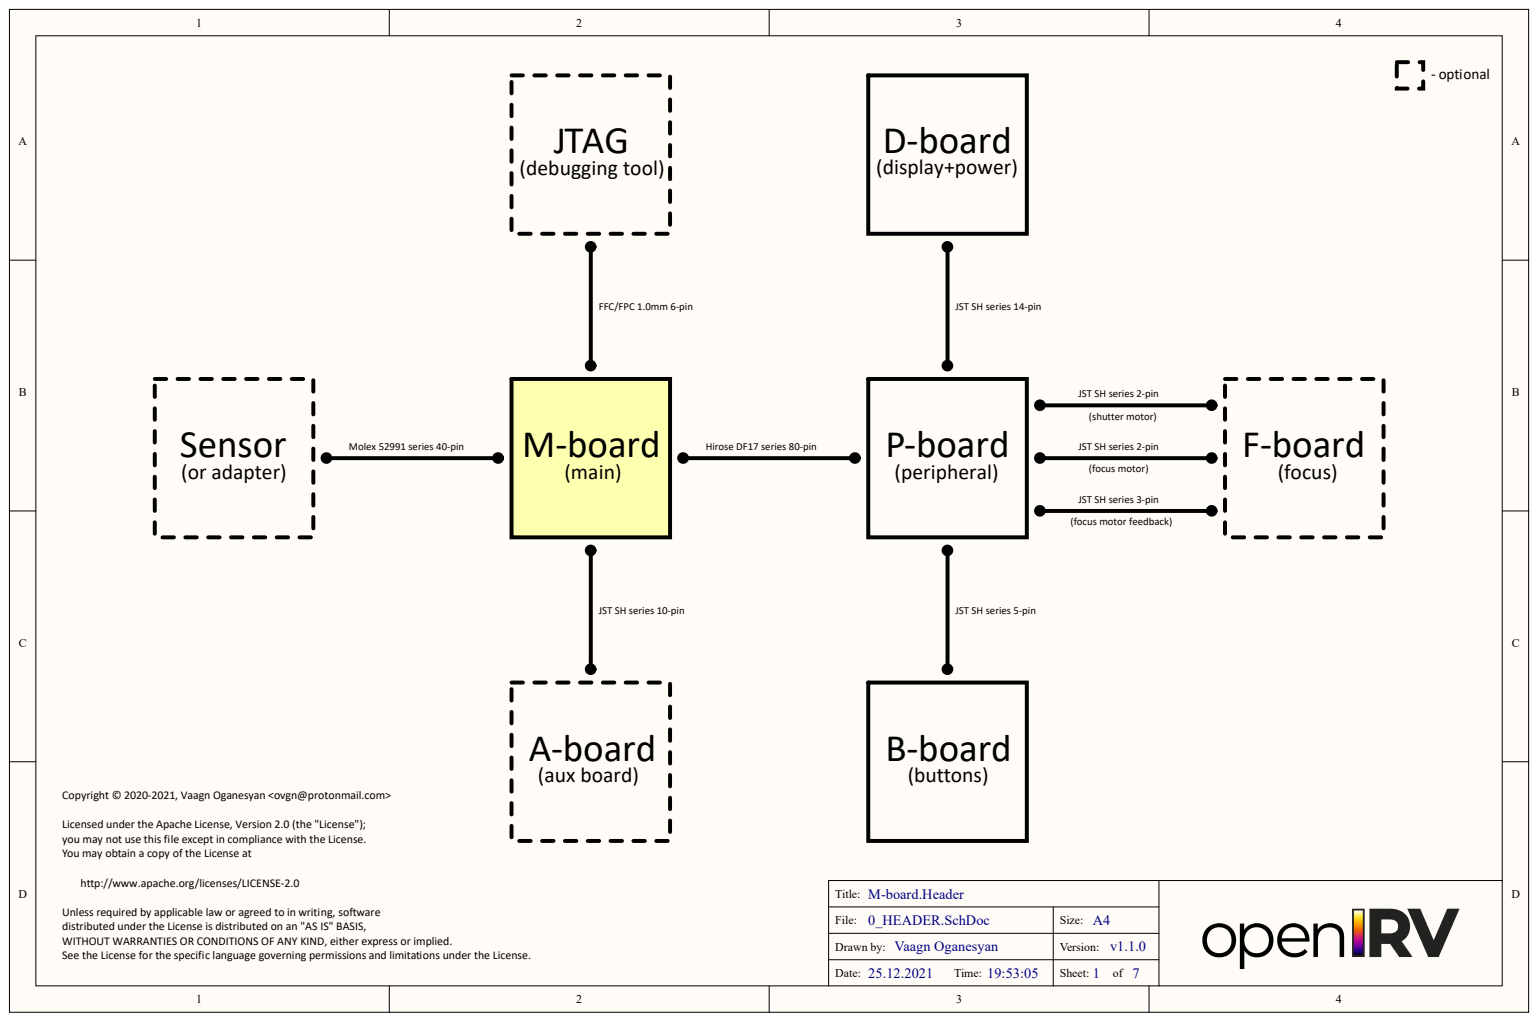
[picture p26: page 1]

JST SH series 14-pin

JST SH series 2-pin

JST SH series 3-pin

JST SH series 10-pin

JST SH series 5-pin

Copyright © 2020-2021, Vaagn Oganesyan <ovgn@protonmail.com>

Licensed under the Apache License, Version 2.0 (the "License");
you may not use this file except in compliance with the License.
You may obtain a copy of the License at

http://www.apache.org/licenses/LICENSE-2.0

Title: M-board.Header

Unless required by applicable law or agreed to in writing, software
distributed under the License is distributed on an "AS IS" BASIS,
WITHOUT WARRANTIES OR CONDITIONS OF ANY KIND, either express or implied.
See the License for the specific language governing permissions and limitations under the License.

File: 0_HEADER.SchDoc | Size: A4

Drawn by: Vaagn Oganesyan | Version: v1.1.0

Date: 25.12.2021 Time: 19:53:05 | Sheet: 1 of 7

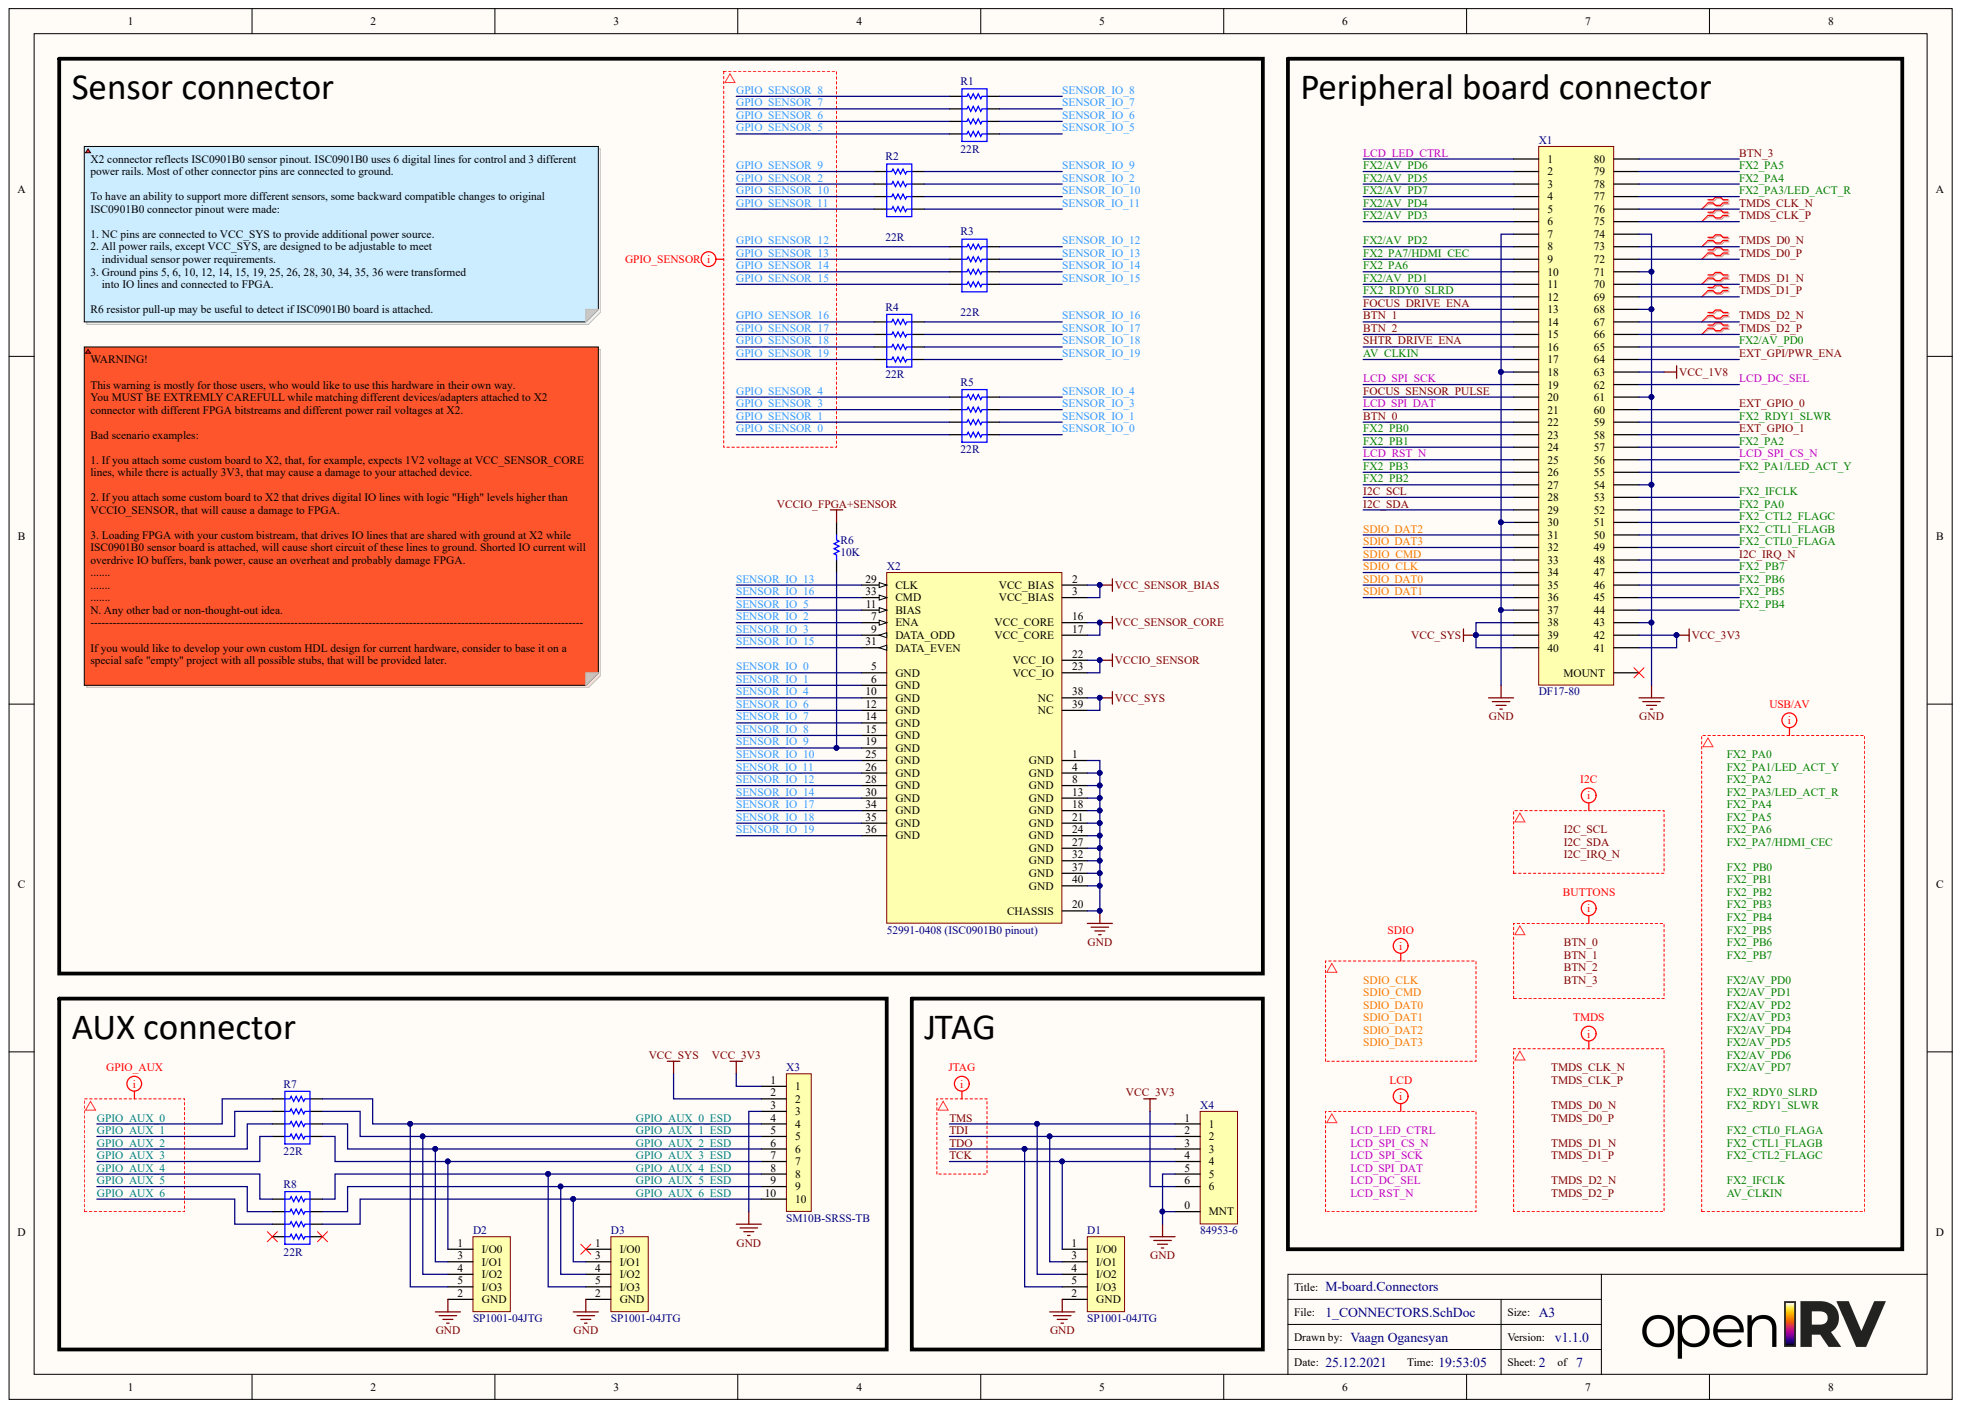
[picture p27: page 2]

X2 connector reflects ISC0901B0 sensor pinout. ISC0901B0 uses 6 digital lines for control and 3 different
power rails. Most of other connector pins are connected to ground. To have an ability to support more different sensors, some backward compatible changes to original

ISC0901B0 connector pinout were made:

1. NC pins are connected to VCC_SYS to provide additional power source.
2. All power rails, except VCC_SYS, are designed to be adjustable to meet
individual sensor power requirements
3. Ground pins 5, 6, 10, 12, 14, 15, 19, 25, 26, 28, 30, 34, 35, 36 were transformed
into IO lines and connected to FPGA.

R6 resistor pull-up may be useful to detect if ISC0901B0 board is attached. WARNING! This warning is mostly for those users, who would like to use this hardware in their own way

You MUST BE EXTRE
connector with different FPGA bitstreams and different power rail voltages at X2.

L while matching different devices/adapters attached to X2

1. If you attach some custom board to X2, that, for example, expects 1V2 voltage at VCC_SENSOR_CORE
lines, while there is actually 3V3, that may cause a damage to your attached device.

2. If you attach some custom board to X2 that drives digital IO lines with logic "High" levels higher than
VCCIO_SENSOR, that will cause a damage to FPGA.

3. Loading FPGA with your custom bistream, that drives IO lines that are shared with ground at X2 while
ISC0901B0 sensor board is attached, will cause short circuit of these lines to ground. Shorted IO current will
overdrive IO buffers, bank power, cause an overheat and probably damage FPGA.
N. Any other bad or non-thought-out idea.

If you would like to develop your own custom HDL design for current hardware, consider to base it on a special safe "empty" project with all possible stubs, that will be provided later.

GPIO_AUX_1 | GPIO_AUX_1_ESD | | 5
GPIO_AUX_2 | | GPIO_AUX_2_ESD | | 6
GPIO_AUX_3 | GPIO_AUX_3_ESD | | 7

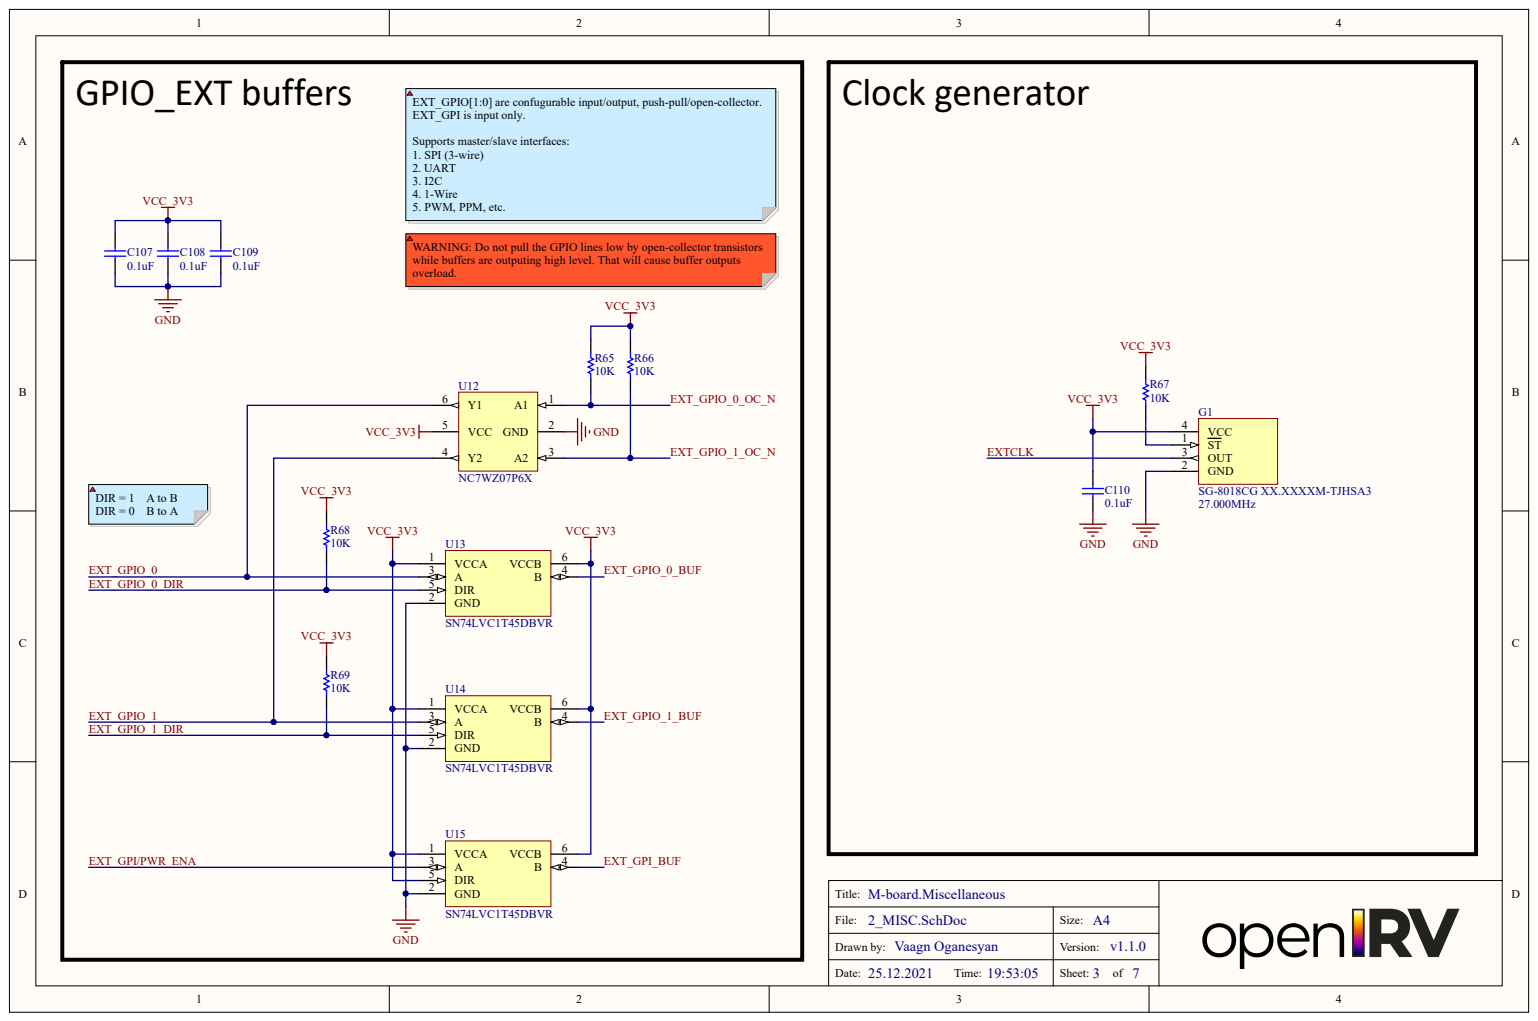
[picture p28: page 3]

EXT_GPIO[1:0] are confugurable input/output, push-pull/open-collector.
EXT_GPI is input only.

WARNING: Do not pull the GPIO lines low by open-collector transistors
while buffers are outputing high level. That will cause buffer outputs
overload.

File: 2_MISC.SchDoc | Size: A4

Drawn by: Vaagn Oganesyan | Version: v1.1.0

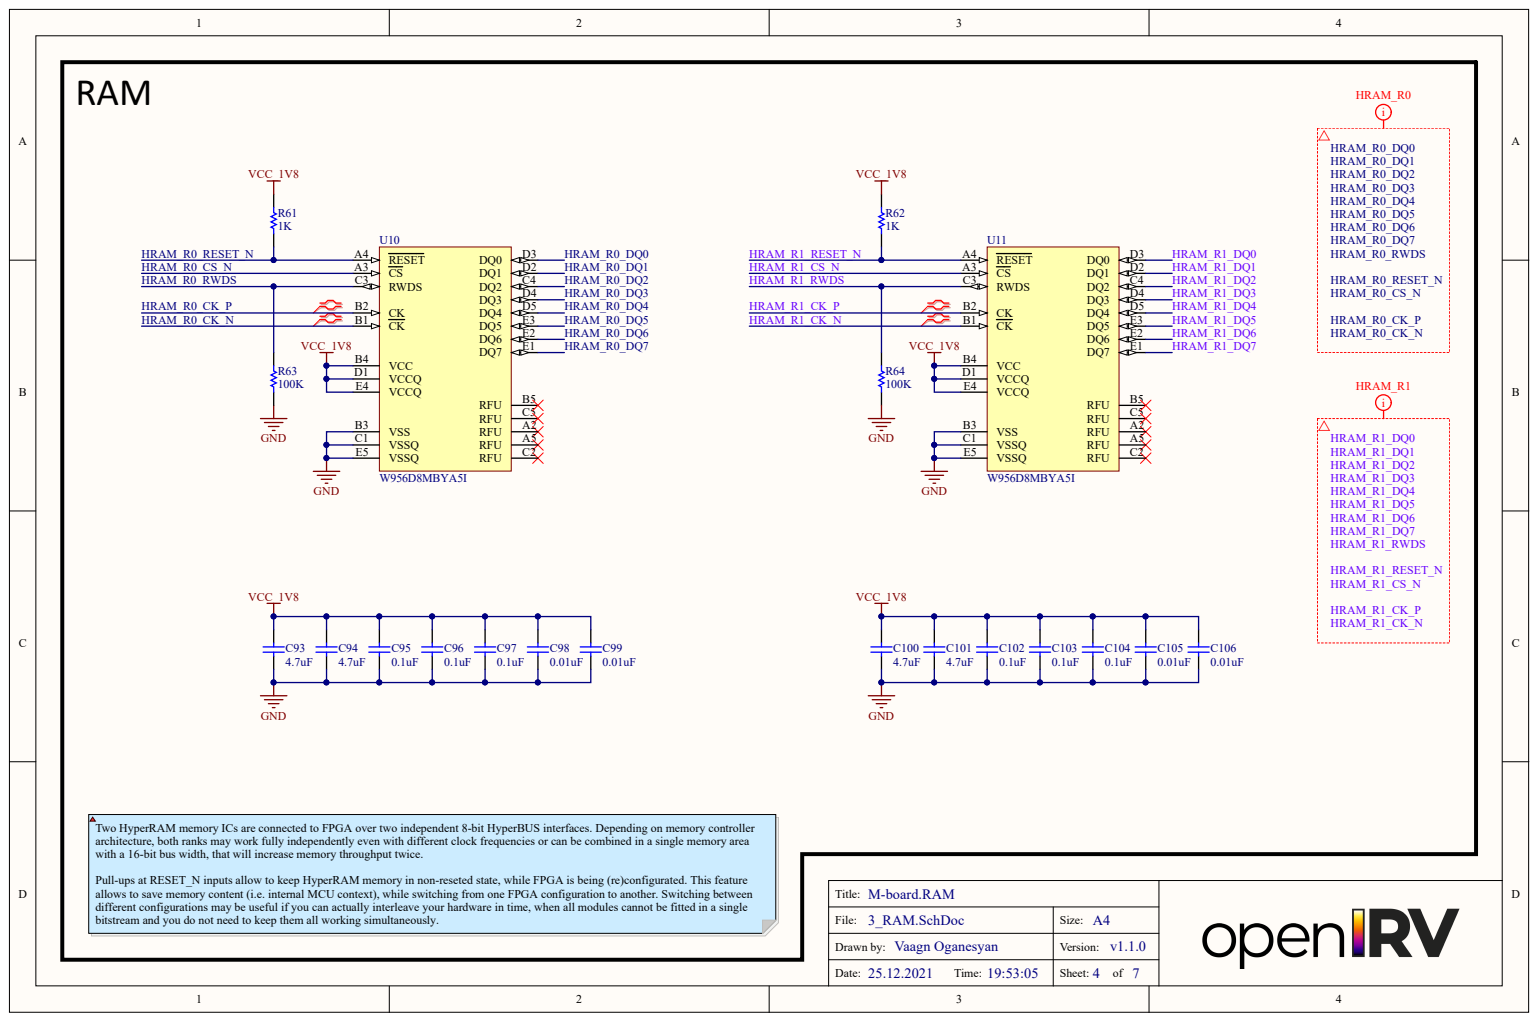
[picture p29: page 4]

Two HyperRAM memory ICs are connected to FPGA over two independent 8-bit HyperBUS interfaces. Depending on memory controller
architecture, both ranks may work fully independently even with different clock frequencies or can be combined in a single memory area
with a 16-bit bus width, that will increase memory throughput twice.

Pull-ups at RESET_N inputs allow to keep HyperRAM memory in non-reseted state, while FPGA is being (re)configurated. This feature
allows to save memory content (i.e. internal MCU context), while switching from one FPGA configuration to another. Switching between
different configurations may be useful if you can actually interleave your hardware in time, when all modules cannot be fitted in a single
bitstream and you do not need to keep them all working simultaneously.

Title: M-board.RAM

File: 3_RAM.SchDoc | Size: A4

Drawn by: Vaagn Oganesyan | Version: v1.1.0

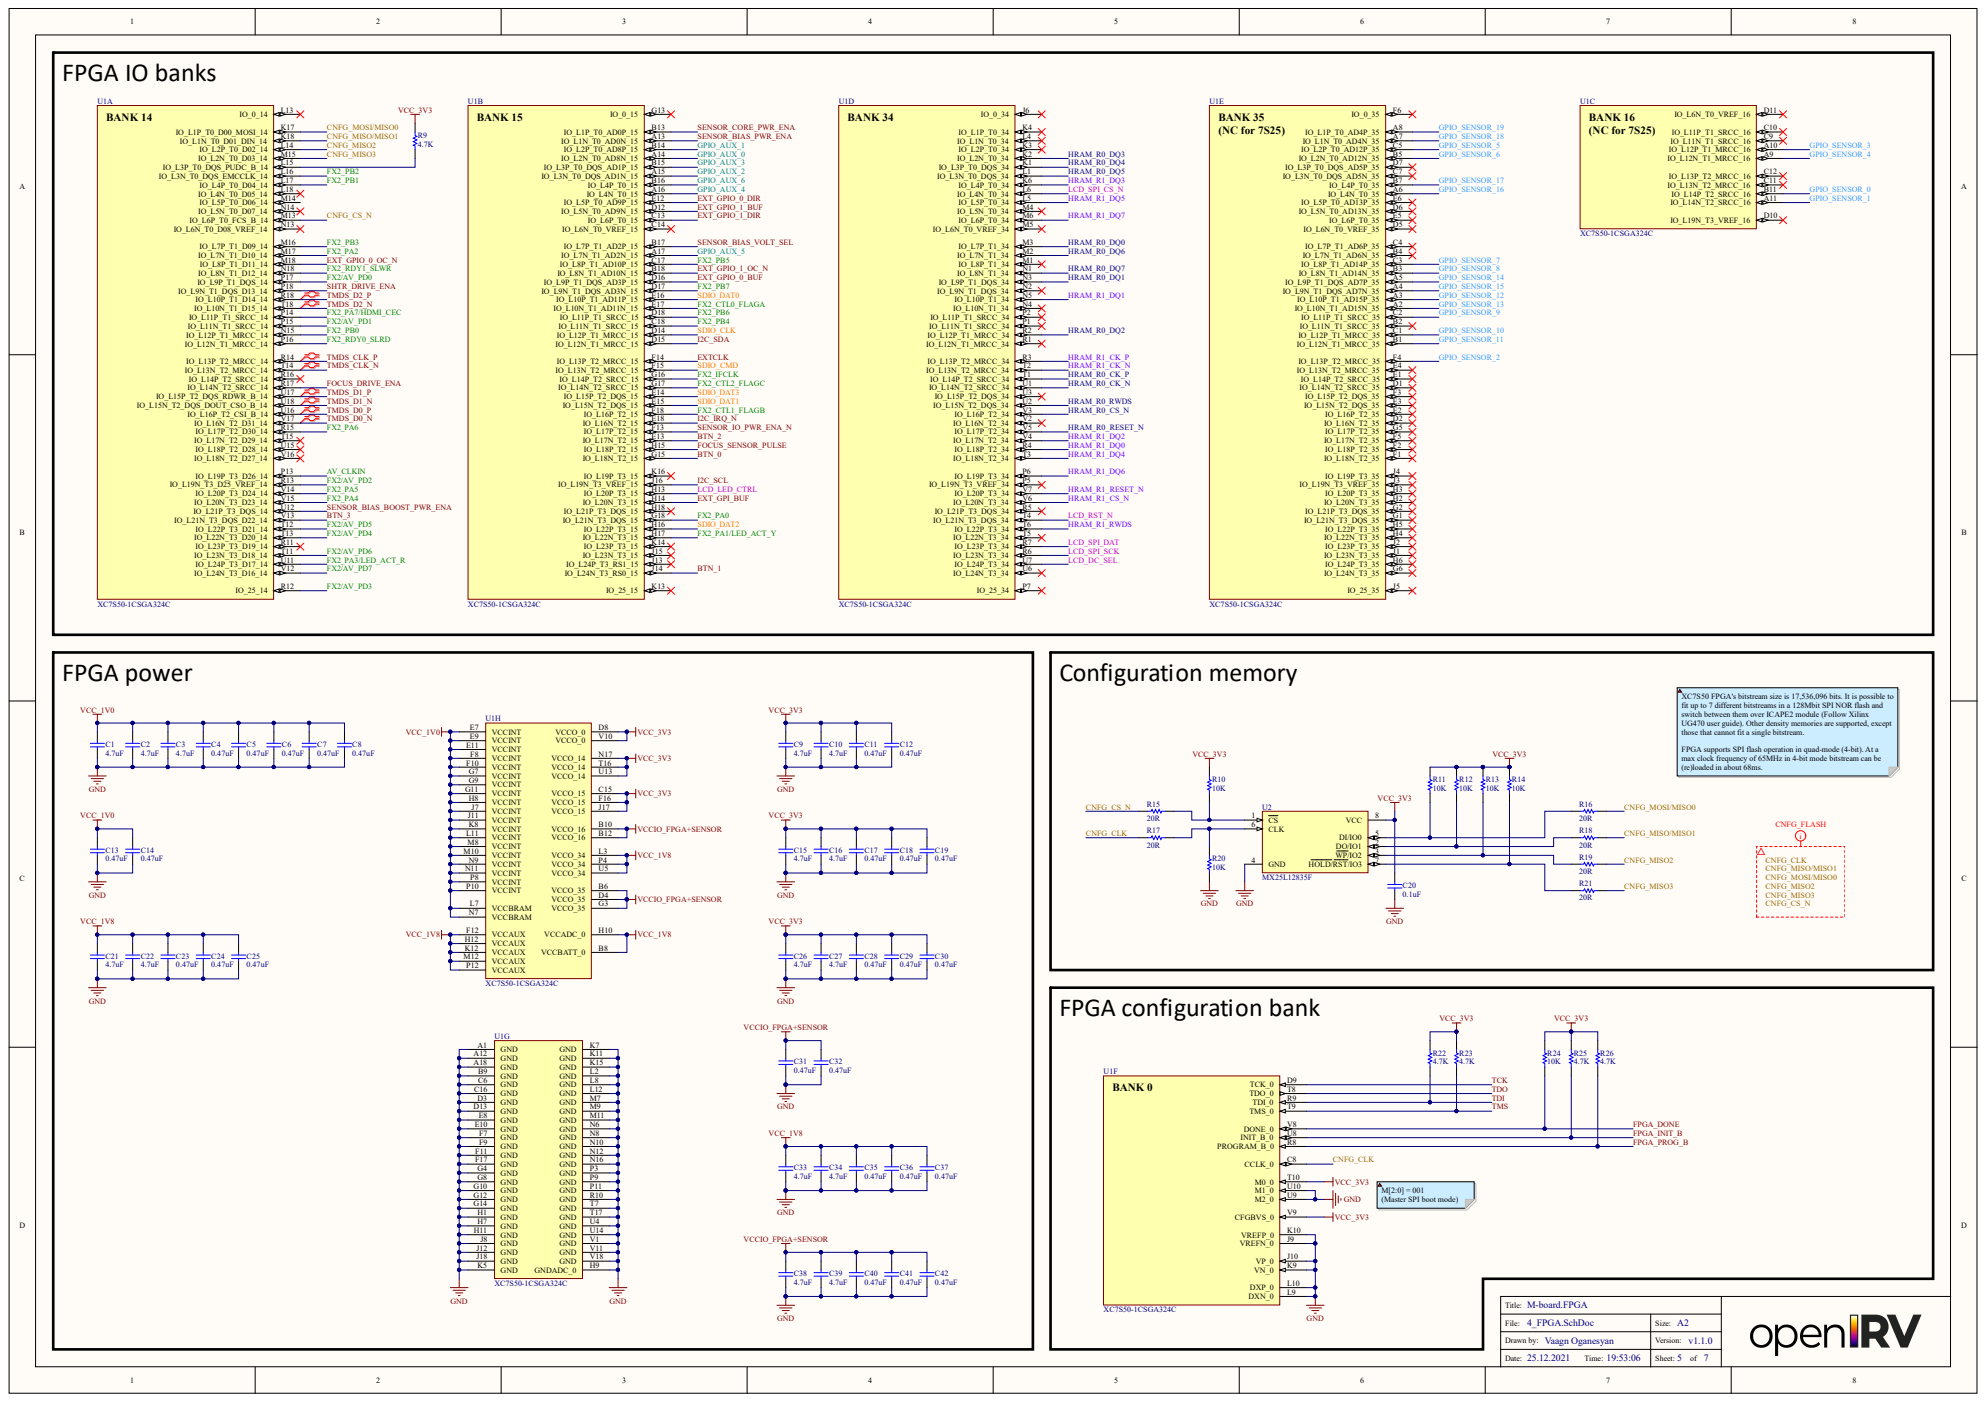
[picture p30: page 5]

PGA's bitstr
ent bitstr
en them ove
r guide
annot fit a single bitstr

e is 17,536,096 bits. It is possible to

I flash ope
equency of 65MHz in 4-bit mode bitstr

ation in quad-mode (4-bit). At a

M[2:0] = 001 (Master SPI boot mode

Title : M-board.FPG A

File : 4_FPG A .SchDoc | Siz rsion:A e :

Dr awn by: Vaagn Oganesyan | Ve v1.1.

Date : 25.12.2021 Time : 19:53:06 | She et: 5 of

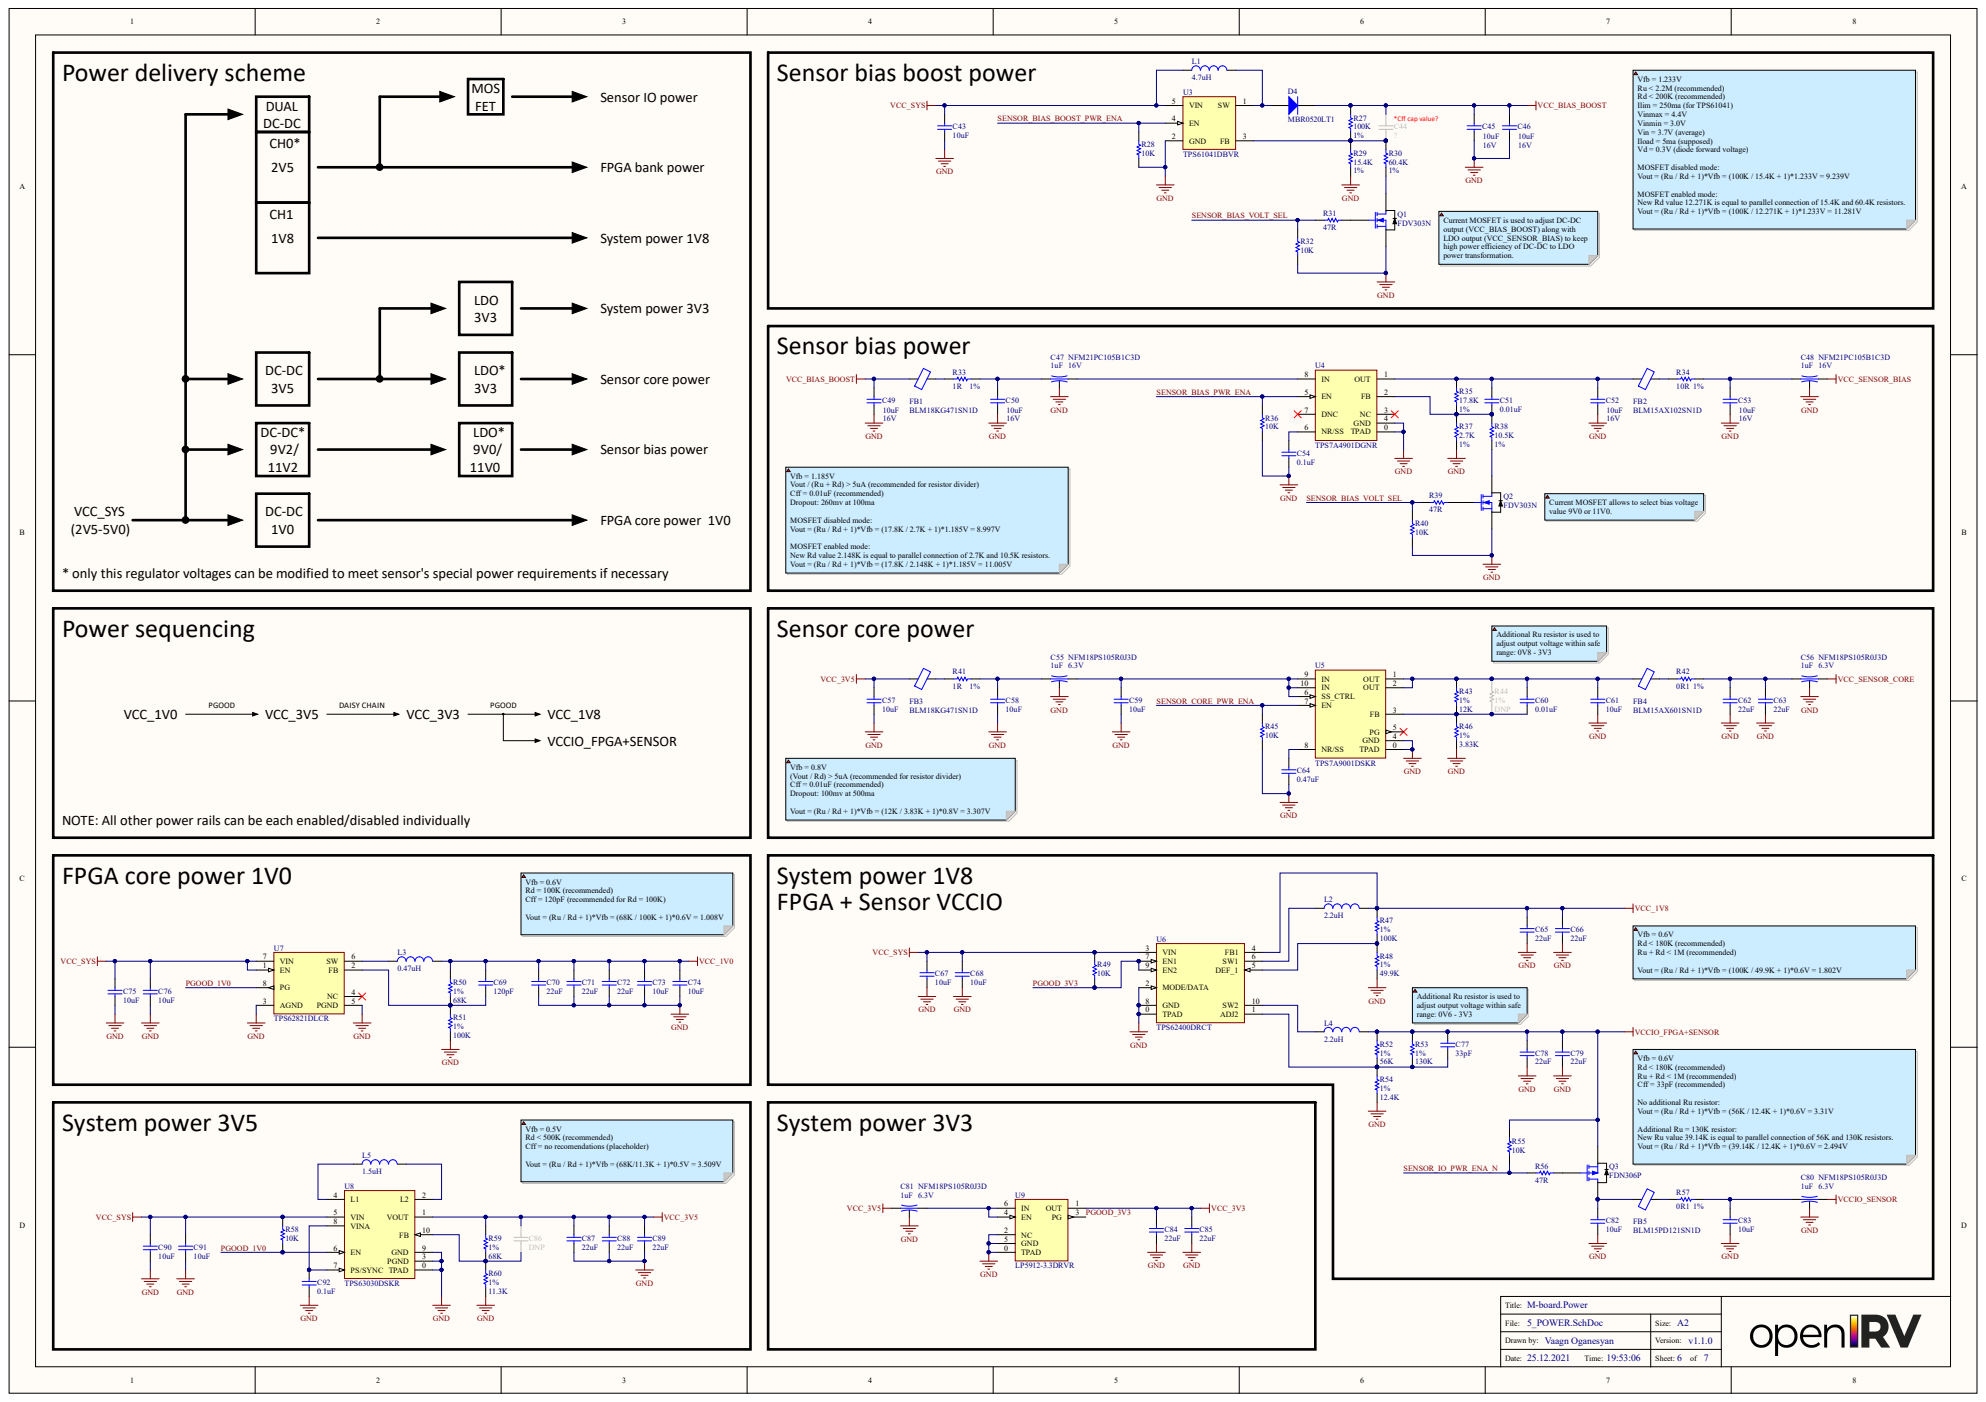
[picture p31: page 6]

Sensor bias boost power

MOS
Sensor IO power FET

MOSFET disabled mode:
Vout = (Ru / Rd + 1)*Vfb = (100K / 15.4K + 1)*1.233V = 9.239V

MOSFET enabled mode:
New Rd value 12.271K is equal to parallel connection of 15.4K and 60.4K resistors.
Vout = (Ru / Rd + 1)*Vfb = (100K / 12.271K + 1)*1.233V = 11.281V

Current MOSFET is used to adjust DC-DC
output (VCC_BIAS_BOOST) along with
LDO output (VCC_SENSOR_BIAS) to keep
high power efficiency of DC-DC to LDO
power transformation.

Vfb = 1.185V
Vout / (Ru + Rd) > 5uA (recommended for resistor divider)
Cff = 0.01uF (recommended)
Dropout: 260mv at 100ma

Vout = (Ru / Rd + 1)*Vfb = (17.8K / 2.7K + 1)*1.185V = 8.997V

Current MOSFET allows to select bias voltage
value 9V0 or 11V0.

New Rd value 2.148K is equal to parallel connection of 2.7K and 10.5K resistors.
Vout = (Ru / Rd + 1)*Vfb = (17.8K / 2.148K + 1)*1.185V = 11.005V

* only this regulator voltages can be modified to meet sensor's special power requirements if necessary

Additional Ru resistor is used to
adjust output voltage within safe
range: 0V8 - 3V3

Vfb = 0.8V
(Vout / Rd) > 5uA (recommended for resistor divider)
Dropout: 100mv at 500ma

NOTE: All other power rails can be each enabled/disabled individually

Vout = (Ru / Rd + 1)*Vfb = (12K / 3.83K + 1)*0.8V = 3.307V

Vfb = 0.6V
Rd = 100K (recommended)
Cff = 120pF (recommended for Rd = 100K)

Vout = (Ru / Rd + 1)*Vfb = (68K / 100K + 1)*0.6V = 1.008V

Vout = (Ru / Rd + 1)*Vfb = (100K / 49.9K + 1)*0.6V = 1.802V

range: 0V6 - 3V3

No additional Ru resistor:
Vout = (Ru / Rd + 1)*Vfb = (56K / 12.4K + 1)*0.6V = 3.31V

Vfb = 0.5V
Rd < 500K (recommended)
Cff = no recomendations (placeholder)

Additional Ru = 130K resistor:
New Ru value 39.14K is equal to parallel connection of 56K and 130K resistors.
Vout = (Ru / Rd + 1)*Vfb = (39.14K / 12.4K + 1)*0.6V = 2.494V

Vout = (Ru / Rd + 1)*Vfb = (68K/11.3K + 1)*0.5V = 3.509V

Title: M-board.Power

File: 5_POWER.SchDoc | Size: A2

Drawn by: Vaagn Oganesyan | Version: v1.1.0

Date: 25.12.2021 Time: 19:53:06 | Sheet: 6 of 7


Title: M-board.ChangeLog

File: 6_CHANGELOG.SchDoc | Size: A4

Drawn by: Vaagn Oganesyan | Version: v1.1.0

Date: 25.12.2021 Time: 19:53:07 | Sheet: 7 of 7
