OVGN/OpenIRV/docs/schematics/P-board_v1.1.0.PDF

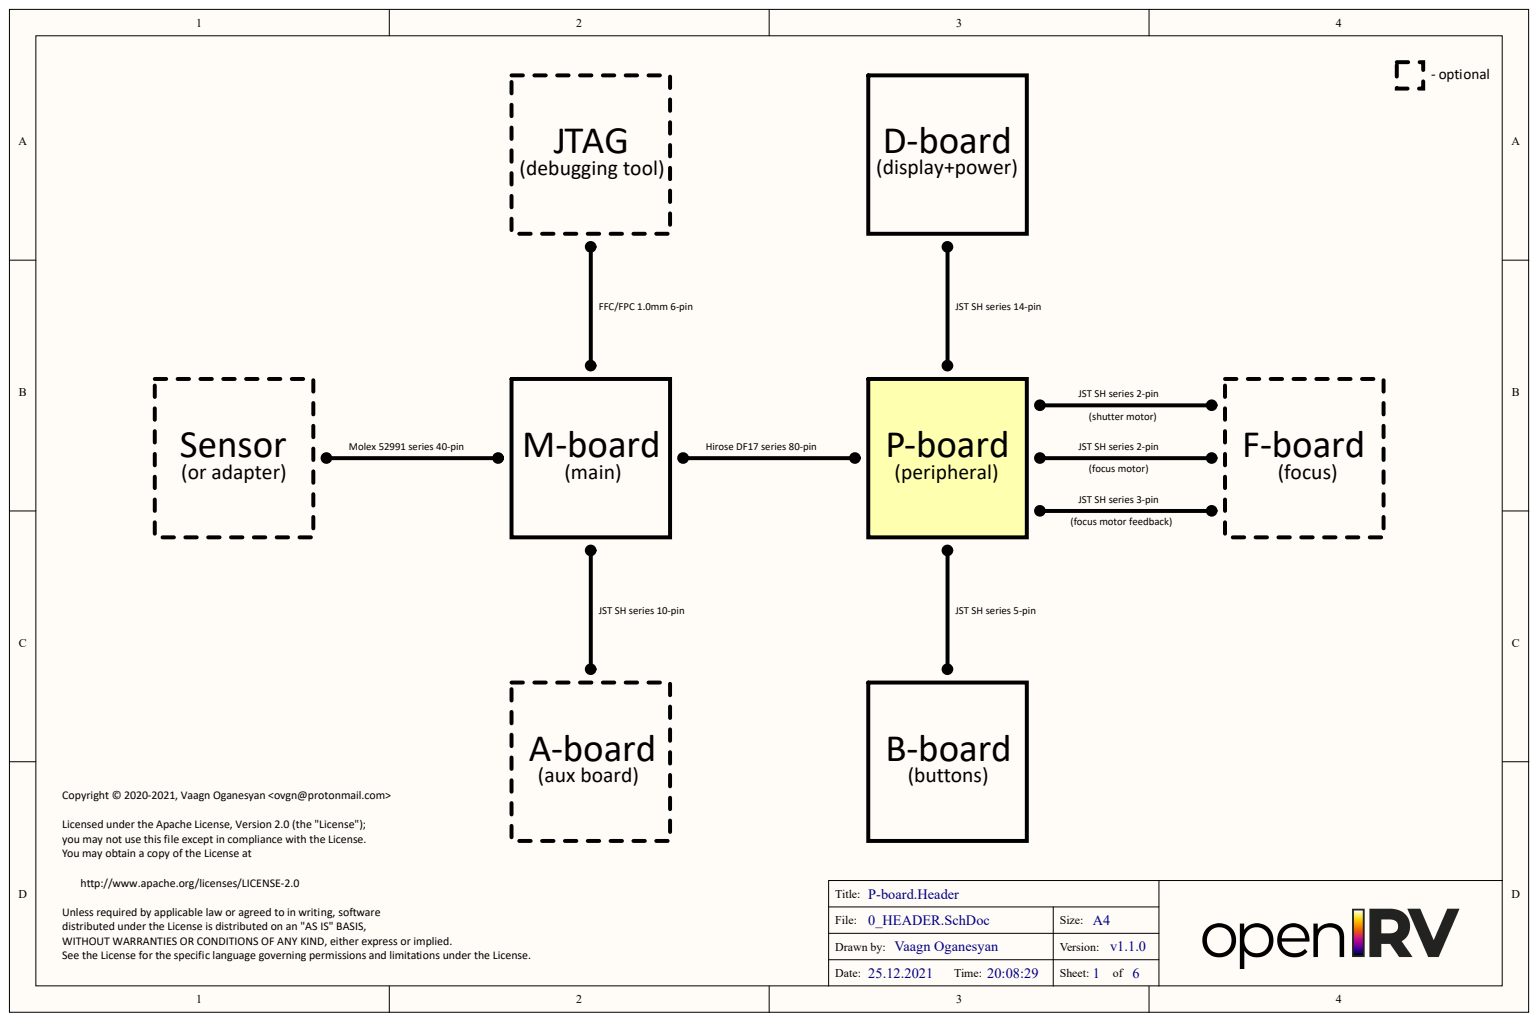
[picture p32: page 1]

JST SH series 14-pin

JST SH series 2-pin

JST SH series 3-pin

JST SH series 10-pin

JST SH series 5-pin

Copyright © 2020-2021, Vaagn Oganesyan <ovgn@protonmail.com>

Licensed under the Apache License, Version 2.0 (the "License");
you may not use this file except in compliance with the License.
You may obtain a copy of the License at

http://www.apache.org/licenses/LICENSE-2.0

Title: P-board.Header

Unless required by applicable law or agreed to in writing, software
distributed under the License is distributed on an "AS IS" BASIS,
WITHOUT WARRANTIES OR CONDITIONS OF ANY KIND, either express or implied.
See the License for the specific language governing permissions and limitations under the License.

File: 0_HEADER.SchDoc | Size: A4

Drawn by: Vaagn Oganesyan | Version: v1.1.0

Date: 25.12.2021 Time: 20:08:29 | Sheet: 1 of 6

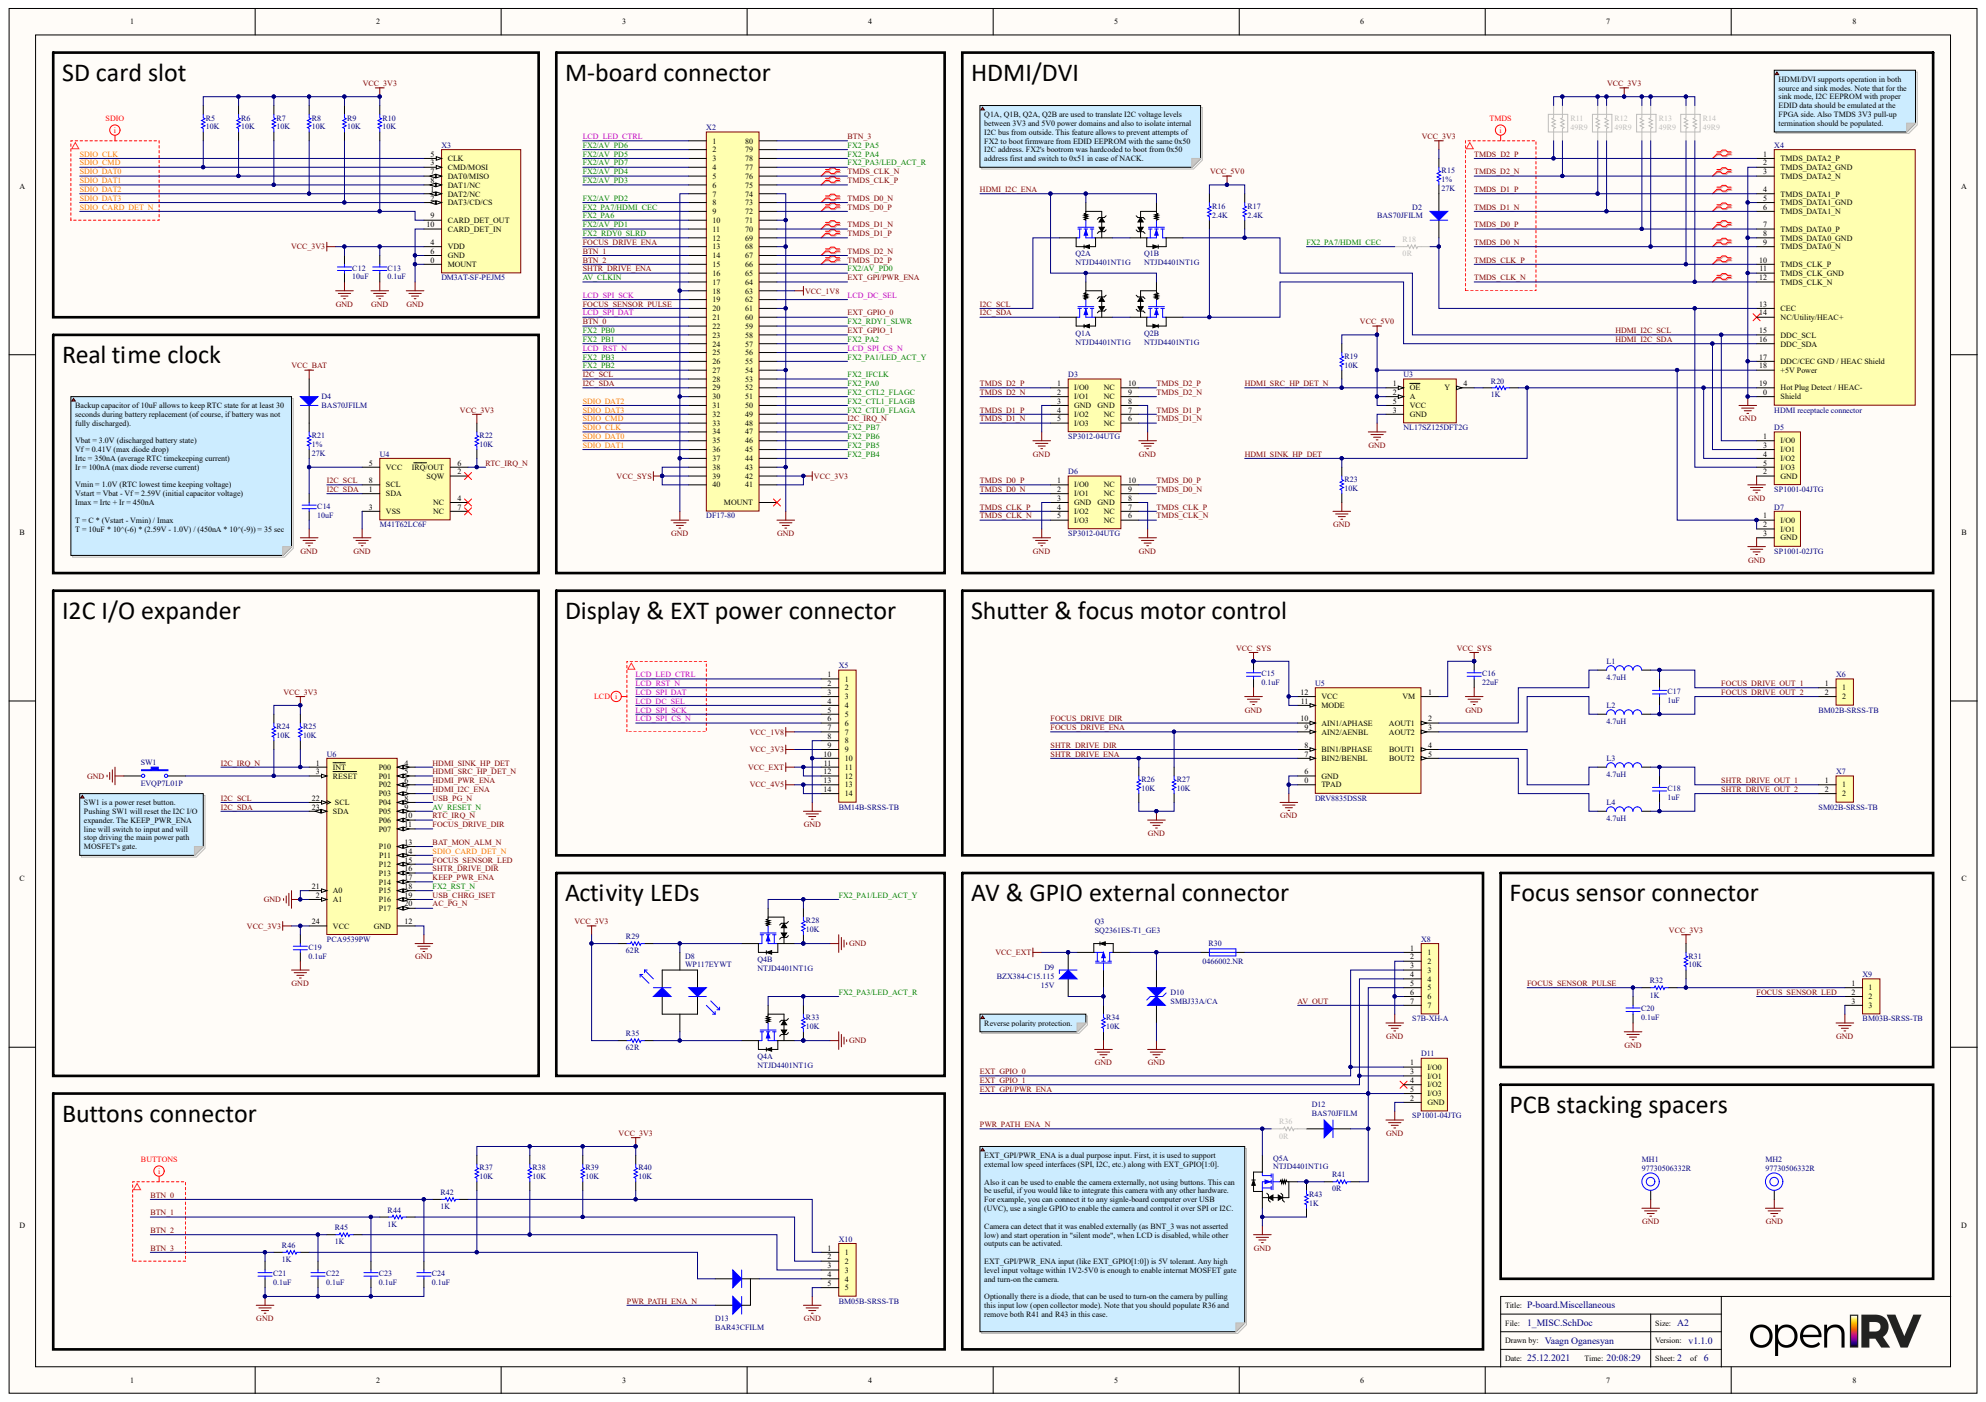
[picture p33: page 2]

HDMI/DVI supports operation in both
source and sink modes. Note that for the
sink mode, I2C EEPROM with proper
EDID data should be emulated at the
FPGA side. Also TMDS 3V3 pull-up
termination should be populated.

Q1A, Q1B, Q2A, Q2B are used to translate I2C voltage levels
between 3V3 and 5V0 power domains and also to isolate internal
I2C bus from outside. This feature allows to prevent attempts of
FX2 to boot firmware from EDID EEPROM with the same 0x50
I2C address. FX2's bootrom was hardcoded to boot from 0x50
address first and switch to 0x51 in case of NACK.

DDC/CEC GND / HEAC Shield 17
+5V Power 18

Hot Plug Detect / HEAC- 19
Shield 0

Backup capacitor of 10uF allows to keep RTC state for at least 30
seconds during battery replacement (of course, if battery was not
fully discharged).

Vbat = 3.0V (discharged battery state)
Vf = 0.41V (max diode drop)
Irtc = 350nA (average RTC timekeeping current)
Ir = 100nA (max diode reverse current)

Vmin = 1.0V (RTC lowest time keeping voltage)
Vstart = Vbat - Vf = 2.59V (initial capacitor voltage)
Imax = Irtc + Ir = 450nA

Display & EXT power connector

SW1 is a power reset button.
Pushing SW1 will reset the I2C I/O
expander. The KEEP_PWR_ENA
line will switch to input and will
stop driving the main power path
MOSFET's gate.

EXT_GPIO_1 | I/O2 4

EXT_GPI/PWR_ENA is a dual purpose input. First, it is used to support
external low speed interfaces (SPI, I2C, etc.) along with EXT_GPIO[1:0].

Also it can be used to enable the camera externally, not using buttons. This can
be useful, if you would like to integrate this camera with any other hardware.
For example, you can connect it to any signle-board computer over USB
(UVC), use a single GPIO to enable the camera and control it over SPI or I2C.

Camera can detect that it was enabled externally (as BNT_3 was not asserted
low) and start operation in "silent mode", when LCD is disabled, while other
outputs can be activated.

2 2
3 3

EXT_GPI/PWR_ENA input (like EXT_GPIO[1:0]) is 5V tolerant. Any high
level input voltage within 1V2-5V0 is enough to enable internat MOSFET gate
and turn-on the camera.

Optionally there is a diode, that can be used to turn-on the camera by pulling
this input low (open collector mode). Note that you should populate R36 and
remove both R41 and R43 in this case.

Title: P-board.Miscellaneous

File: 1_MISC.SchDoc | Size: A2

Drawn by: Vaagn Oganesyan | Version: v1.1.0

Date: 25.12.2021 Time: 20:08:29 | Sheet: 2 of 6

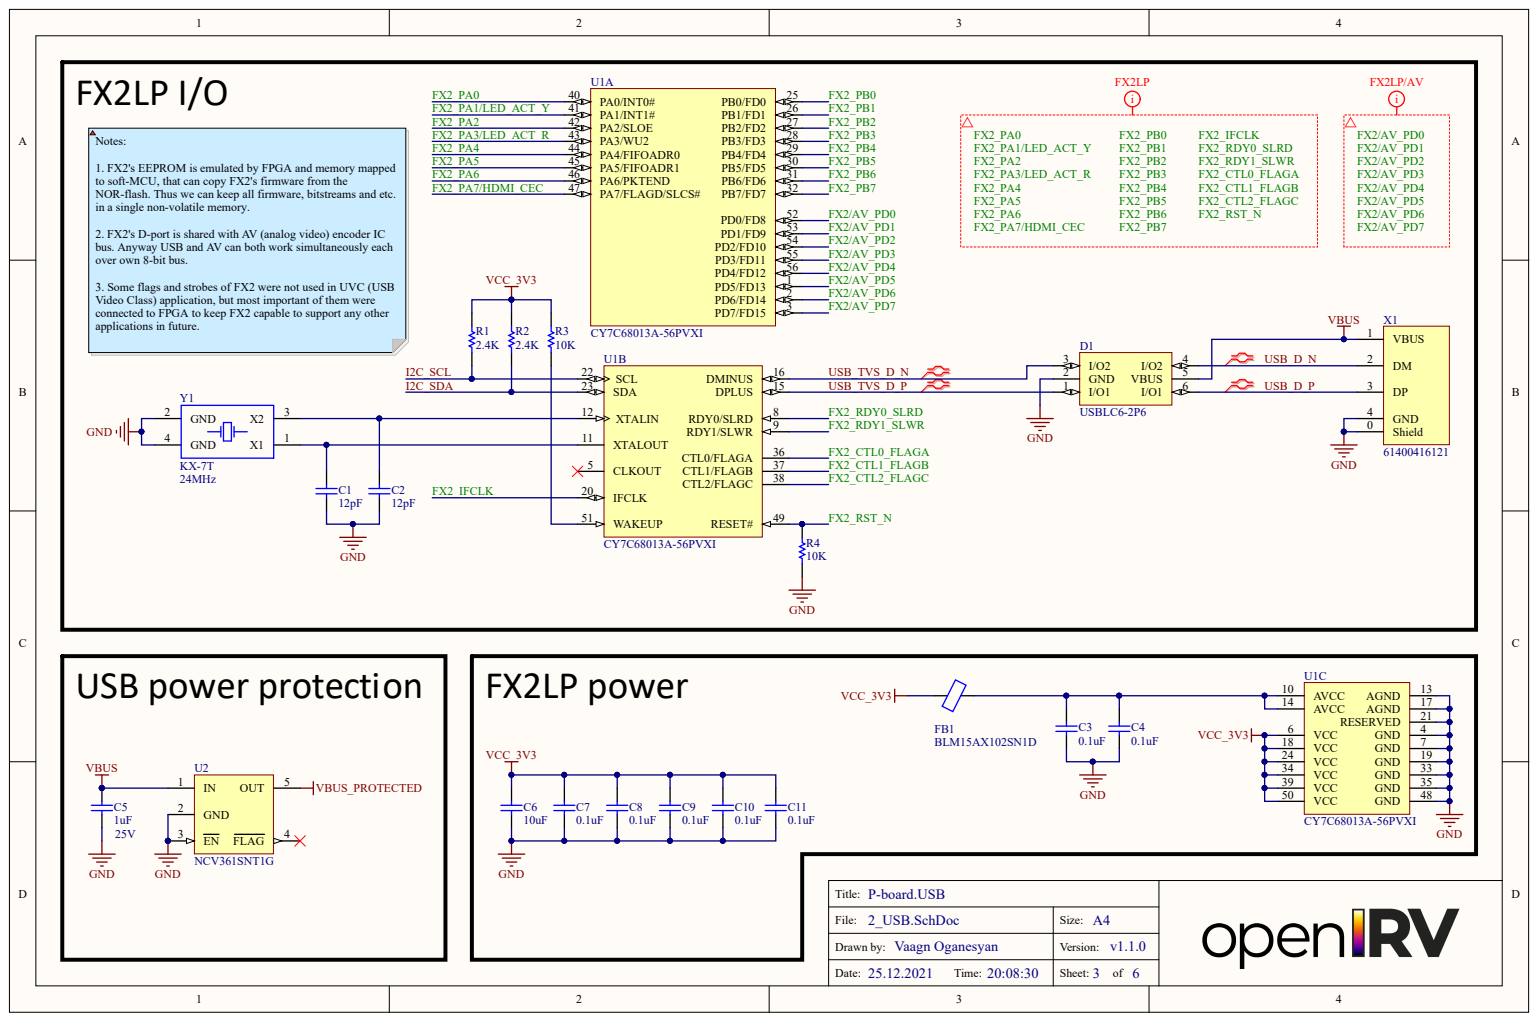
[picture p34: page 3]

1. FX2's EEPROM is emulated by FPGA and memory mapped
to soft-MCU, that can copy FX2's firmware from the
NOR-flash. Thus we can keep all firmware, bitstreams and etc.
in a single non-volatile memory

2. FX2's D-port is shared with
bus. Anyway USB and
over own 8-bit bus.

AV (analog video) encoder IC

AV can both work simultaneously each

3. Some flags and strobes of FX2 were not used in UVC (USB Video Class) application, but most important of them were

connected to FPGA to keep FX2 capable to support any other
applications in future.

USB_TVS_D_P | | USB_D_P

Title: P-board.USB

File: 2_USB.SchDoc | Size: Version: A4

Drawn by: Vaagn Oganesyan | v1.1.0

Date: 25.12.2021 Time: 20:08:30 | Sheet: 3 of

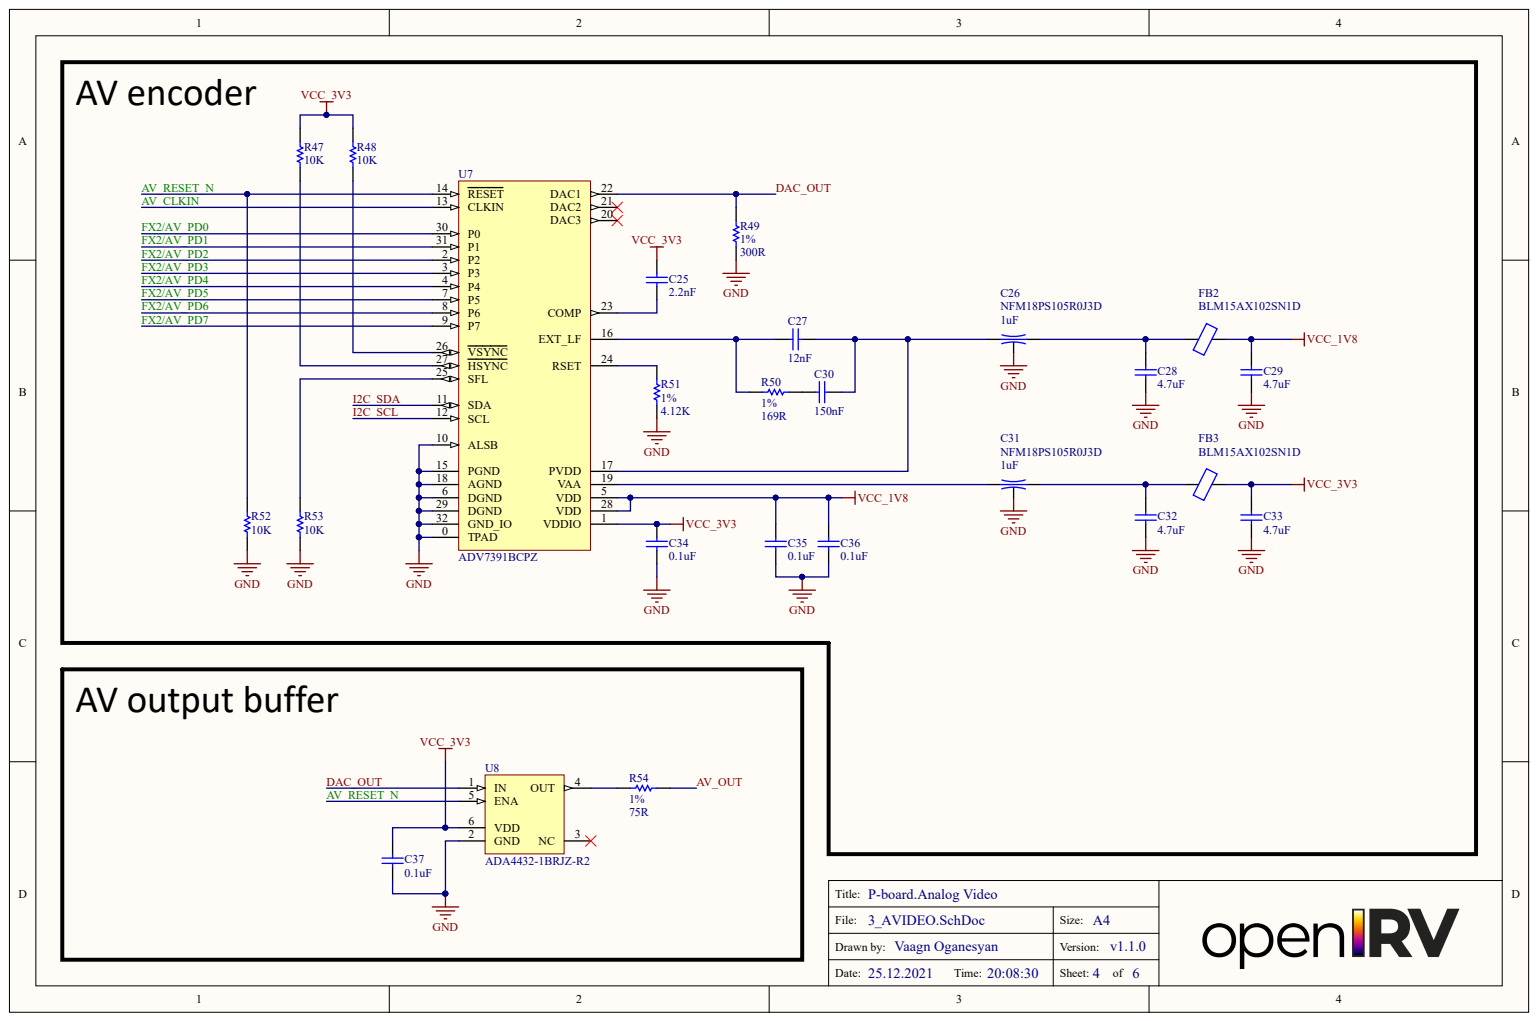
[picture p35: page 4]

SFL 25 | GND

I2C_SDA | SDA 11

Title: P-board.Analog Video

File: 3_AVIDEO.SchDoc | Size: A4

Drawn by: Vaagn Oganesyan | Version: v1.1.0

Date: 25.12.2021 Time: 20:08:30 | Sheet: 4 of 6

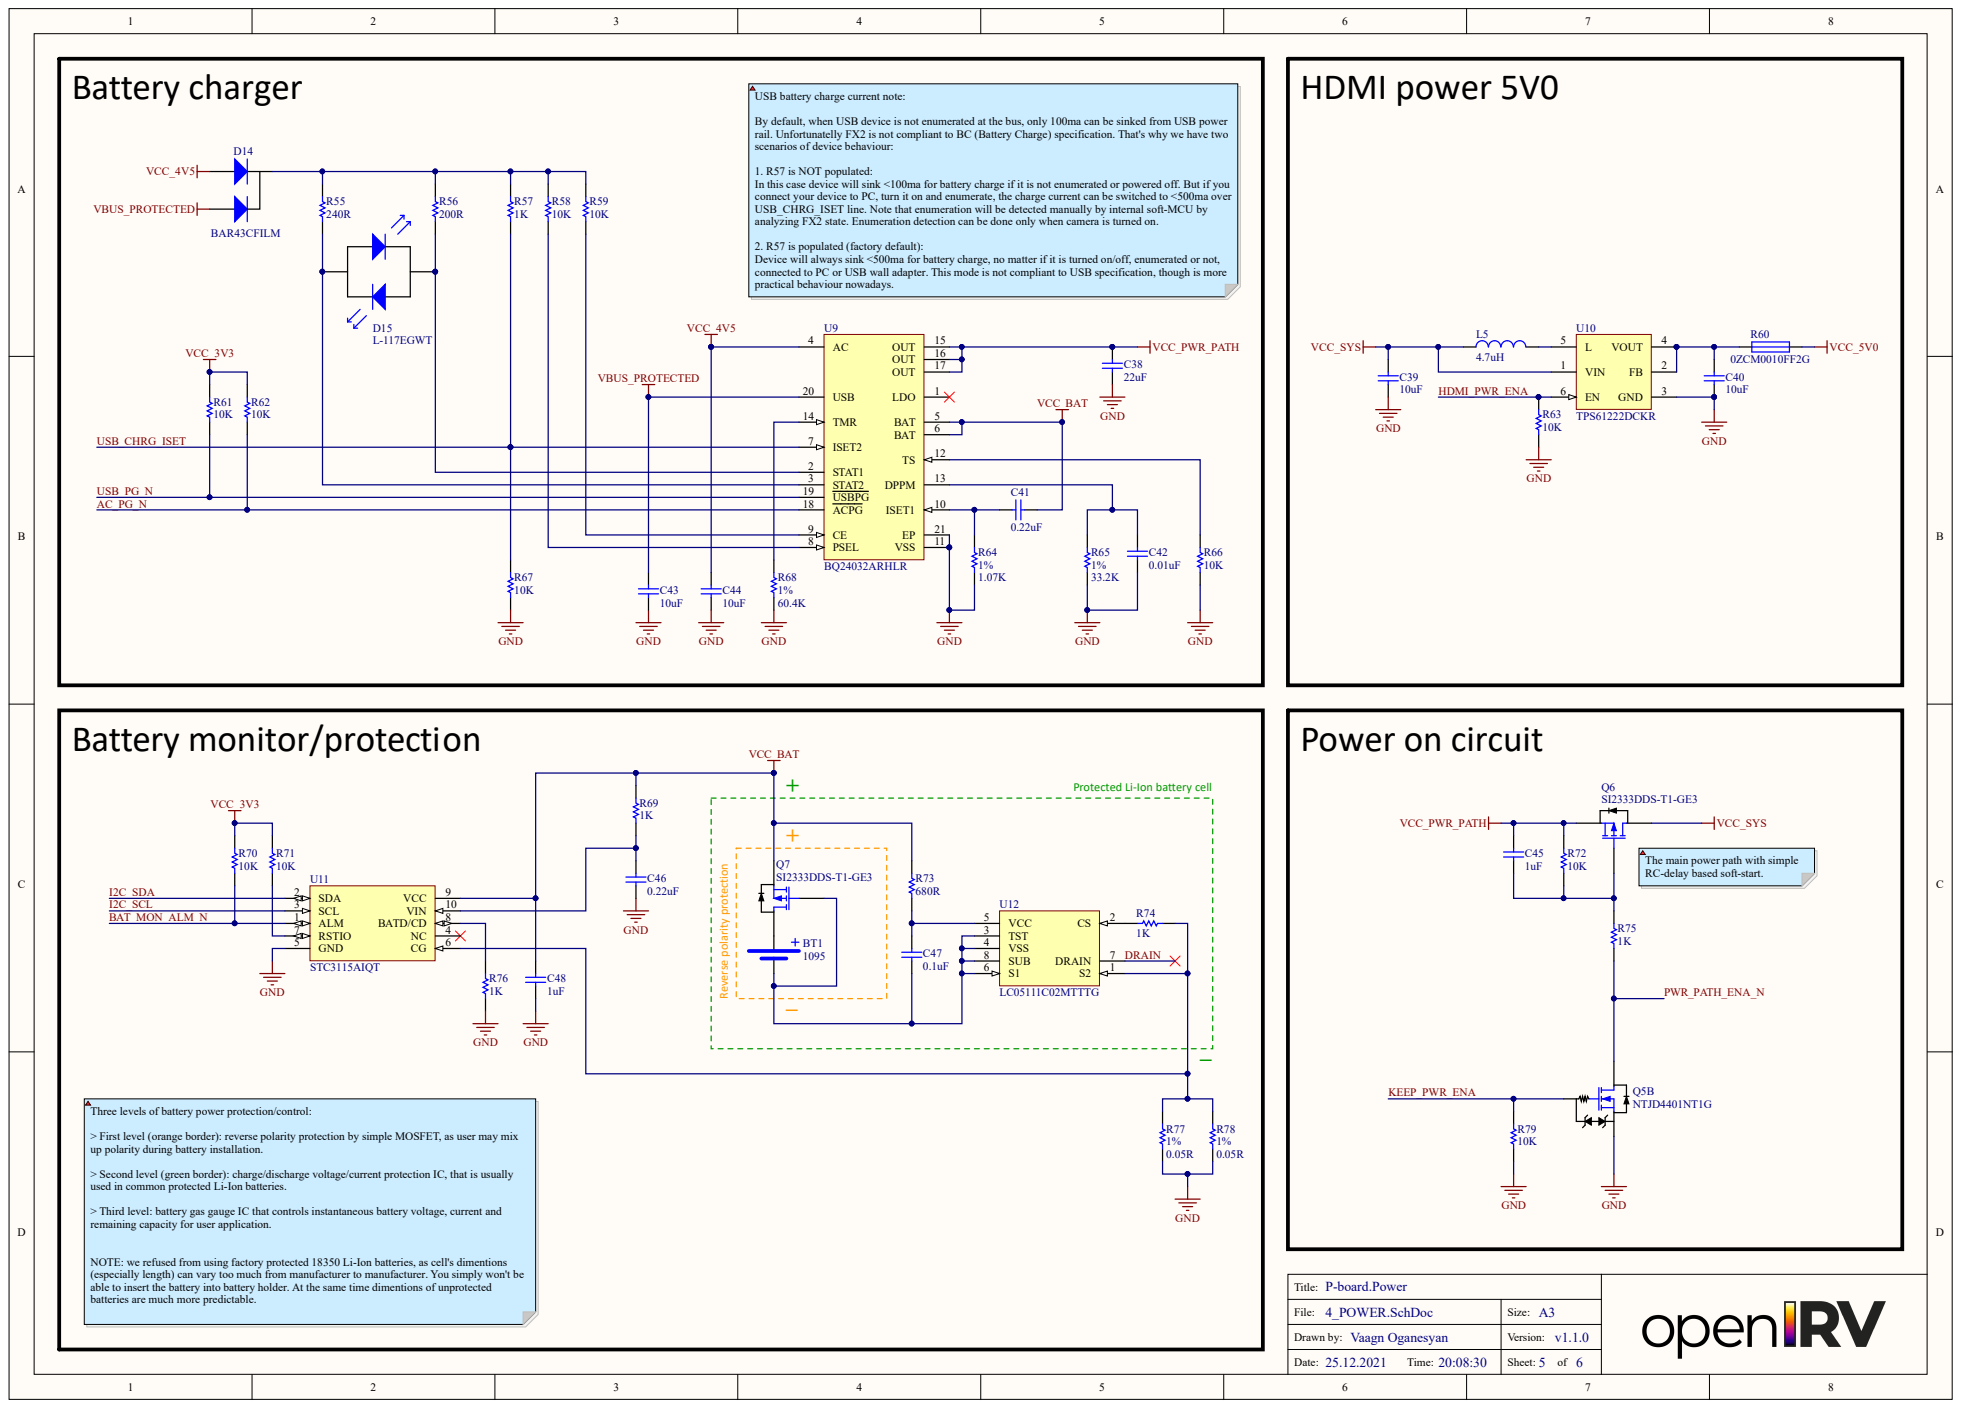
[picture p36: page 5]

USB battery charge current note:

By default, when USB device is not enumerated at the bus, only 100ma can be sinked from USB power
rail. Unfortunatelly FX2 is not compliant to BC (Battery Charge) specification. That's why we have two
scenarios of device behaviour:

1. R57 is NOT populated:
In this case device will sink <100ma for battery charge if it is not enumerated or powered off. But if you
connect your device to PC, turn it on and enumerate, the charge current can be switched to <500ma over
USB_CHRG_ISET line. Note that enumeration will be detected manually by internal soft-MCU by
analyzing FX2 state. Enumeration detection can be done only when camera is turned on.

2. R57 is populated (factory default):
Device will always sink <500ma for battery charge, no matter if it is turned on/off, enumerated or not,
connected to PC or USB wall adapter. This mode is not compliant to USB specification, though is more
practical behaviour nowadays.

STAT2 3

Protected Li-Ion battery cell

The main power path with simple
RC-delay based soft-start.

Three levels of battery power protection/control:

> First level (orange border): reverse polarity protection by simple MOSFET, as user may mix
up polarity during battery installation.

> Second level (green border): charge/discharge voltage/current protection IC, that is usually
used in common protected Li-Ion batteries.

> Third level: battery gas gauge IC that controls instantaneous battery voltage, current and
remaining capacity for user application.

NOTE: we refused from using factory protected 18350 Li-Ion batteries, as cell's dimentions
(especially length) can vary too much from manufacturer to manufacturer. You simply won't be
able to insert the battery into battery holder. At the same time dimentions of unprotected
batteries are much more predictable.

Title: P-board.Power

File: 4_POWER.SchDoc | Size: A3

Drawn by: Vaagn Oganesyan | Version: v1.1.0


Title: P-board.ChangeLog

File: 5_CHANGELOG.SchDoc | Size: A4

Drawn by: Vaagn Oganesyan | Version: v1.1.0
