OVGN/OpenIRV/(commit log)

2020-08-25 mechanical pre-alpha parts
    Initial commit of mechanical parts (pre-alpha)
    [bottom_h13.stp, bottom_h7.stp, buttons.stp, buttons_matrix.stp, focus_wheel.stp, focus_worm.stp, middle.stp, motor_mount.stp]
2020-08-31 B-board and M-board v0.1.0
    B-board, M-board schematics v0.1.0
2020-09-07 P-board v0.1.0 + M-board v0.2.0
2020-10-23 Whole set of schematics
    D-board (v0.1.0), F-board (v0.1.0), M-board (v0.2.0 -> v0.3.0), P-board (v0.1.0 -> v0.2.0)
2020-11-22 Create pixelshift_xy_stage.stp
    Initial version of pixel shift XY-stage
    [pixelshift_xy_stage.stp]
2020-12-09 Schematics v1.0.0
    Whole set of schematics v1.0.0
2021-02-06 New OIRV0901 architecture + OIRVBOOT design
    Redesigned OIRV0901 HDL architecture, now we have separate VDMA, DIP and Sensor cores. OIRVBOOT is a special separate "golden" booting bitstream.
    [constrs.xdc]
2021-09-23 Added v1.1.0 BOMs
    [OpenIRV_B-board_BOM_v1.1.0.xlsx, OpenIRV_D-board_BOM_v1.1.0.xlsx, OpenIRV_F-board_BOM_v1.1.0.xlsx, OpenIRV_M-board_BOM_v1.1.0.xlsx, OpenIRV_P-board_BOM_v1.1.0.xlsx]
2021-12-25 Schematics v1.1.0
    Updated all schematics to v1.1.0
2022-02-01 Stencils v1.1.X
    [BB_v1.1.X_stencil.GBP, BB_v1.1.X_stencil.GTP, DB_v1.1.X_stencil.GTP, FB_v1.1.X_stencil.GBP, MB_v1.1.X_stencil.GBP, MB_v1.1.X_stencil.GTP, PB_v1.1.X_stencil.GBP, PB_v1.1.X_stencil.GTP]
2022-02-02 Added J-board schematic docs
2022-07-28 Added docs for LCD and focus motor
